antmerlino/SumoBot/Mechanical/Rendering/side.JPG

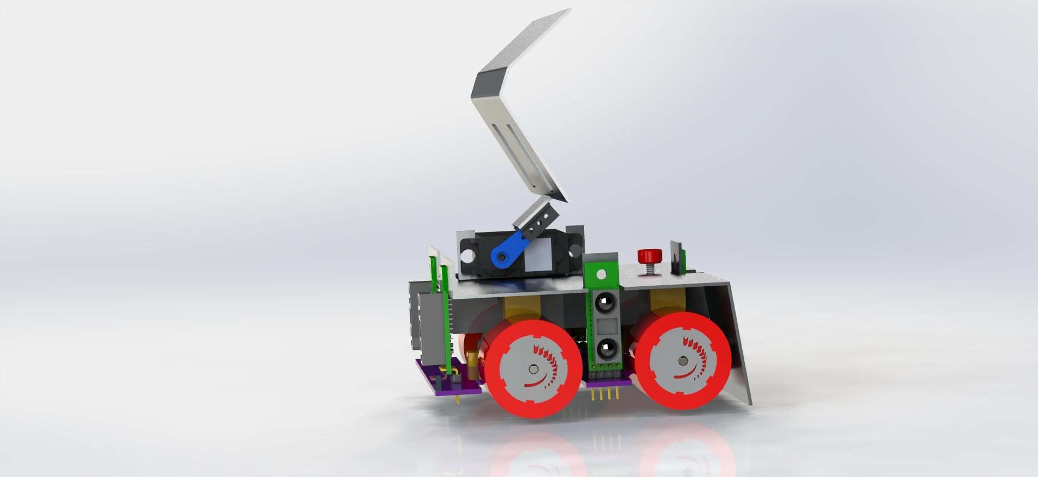
Mechanical/Rendering/side.JPG
