antmerlino/SumoBot/Mechanical/Rendering/back_shot.JPG

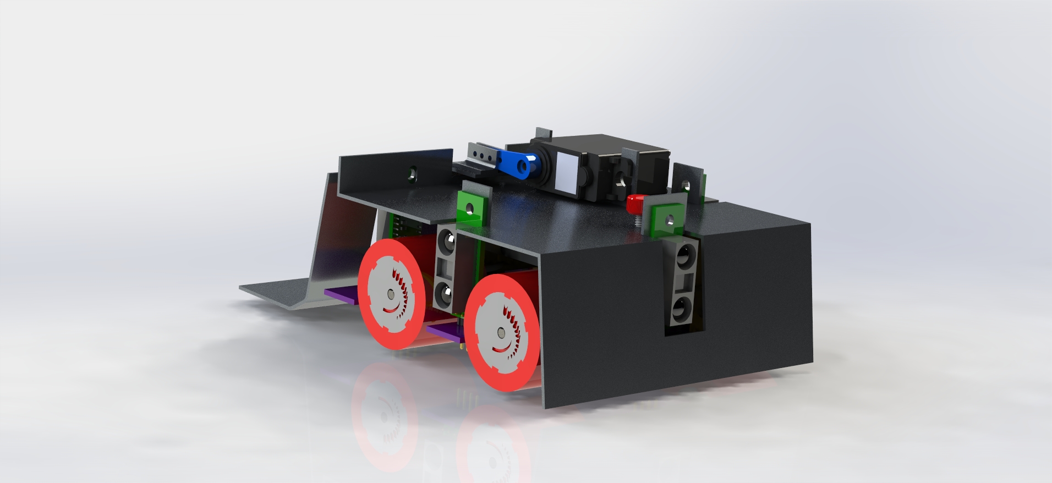
Mechanical/Rendering/back_shot.JPG
