antmerlino/SumoBot/Mechanical/Rendering/akjdlfs.JPG

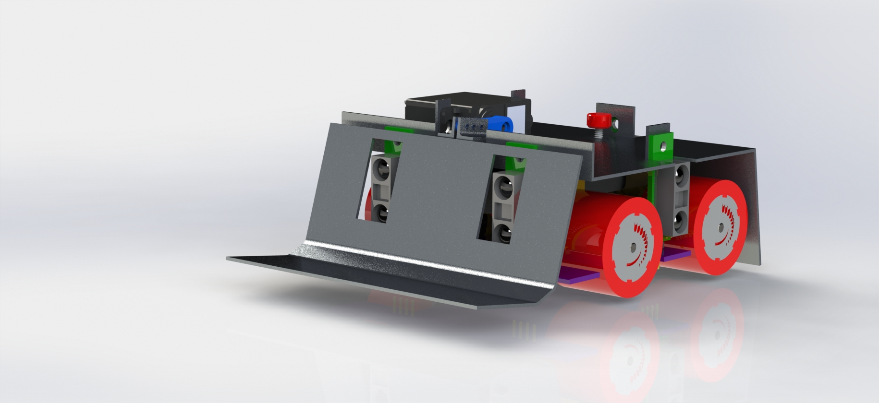
Mechanical/Rendering/akjdlfs.JPG
