antmerlino/SumoBot/Mechanical/Rendering/perspective_preview.JPG

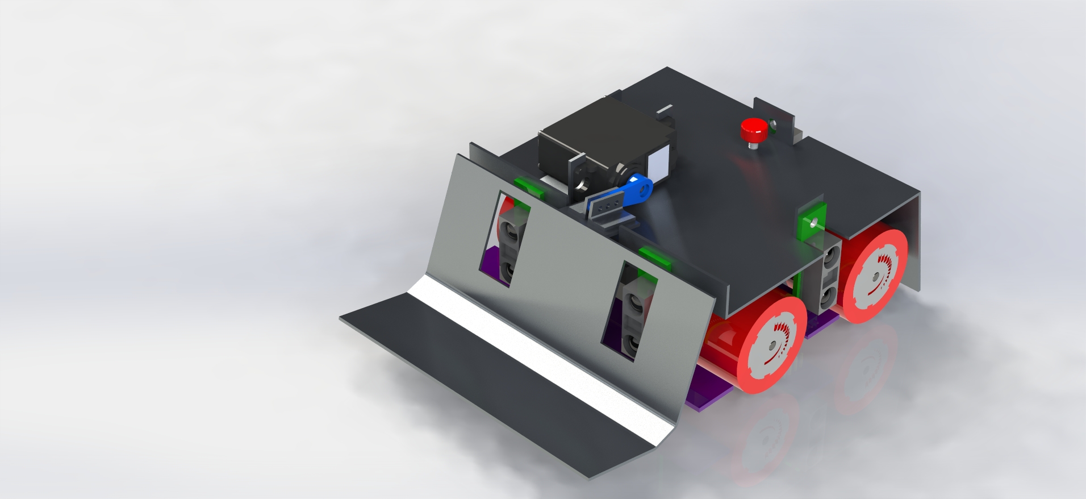
Mechanical/Rendering/perspective_preview.JPG
