antmerlino/SumoBot/Mechanical/Rendering/preview-perspective.JPG

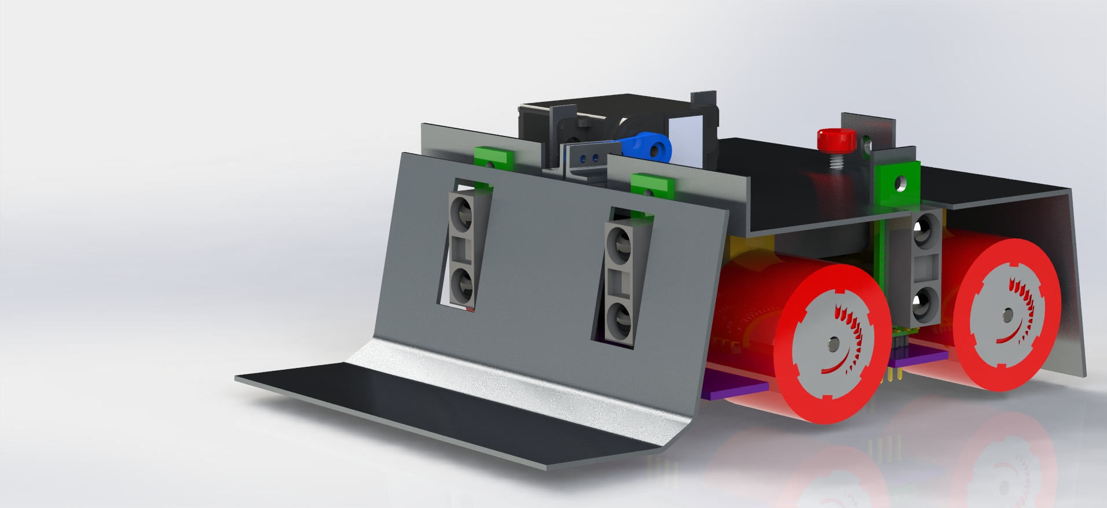
Mechanical/Rendering/preview-perspective.JPG
