antmerlino/SumoBot/Documentation/BOM.ods

Sheet: Sheet1
Micro Metal Gear Motors | 4 | $10.00 | $40.00
FingerTech Wheels | 2 | $16.90 | $33.80
PCB Board | 1 | $23.02 | $23.02
Infrared Proximity | 5 | $11.00 | $55.00
Battery Connector | 1 | $0.70 | $0.70
Batteries | 1 | $6.90 | $6.90
Electronics | 1 | $31.46 | $31.46
Servo and arm | 1 | $40.28 | $40.28
Raw Materials | 1 | $18.00 | $18.00
Total |  |  | $249.16
Micro Metal Gear Motors | 4 | $10.00 | $40.00 | ServoCity | https://www.servocity.com/html/460_rpm_micro_gearmotorblocks.html#.VG-OTPldVCg
FingerTech Wheels | 2 | $16.82 | $33.64 | FingerTech | http://www.fingertechrobotics.com/proddetail.php?prod=ft-minisumo-wheels-1125
PCB Board | 0.333 | 69.05 | $22.99 | OshPark
Infrared Proximity | 5 | $11.95 | $59.75 | Pololu | http://www.pololu.com/product/2474
Batteries | 1 | $6.90 | $6.90 | Ebay
Electronics | 1 | $31.55 | $31.55 | Mouser | See receipt
Servo and arm | 1 | $40.28 | $40.28 | Amazon
Raw Materials | 1 | $12.00 | $12.00 | McMaster | (Over estimated)
Total |  |  | $247.11

Sheet: Sheet2
Motor Controller | 2 | $3.00 | $6.00
Tiva C | 1 | $11.00 | $11.00
Accelerometer | 1 | $3.00 | $3.00
Reflective Sensor | 3 | $1.00 | $3.00
 |  |  | $0.00
 |  |  | $0.00
 |  |  | $0.00
Total |  |  | $23.00

Sheet: Sheet4
Bill of Materials
Micro Metal Gear Motors | 4 | $10.00 | $40.00 | ServoCity | https://www.servocity.com/html/460_rpm_micro_gearmotorblocks.html#.VG-OTPldVCg
FingerTech Wheels | 2 | $16.82 | $33.64 | FingerTech | http://www.fingertechrobotics.com/proddetail.php?prod=ft-minisumo-wheels-1125
PCB Board | 0.333 | 69.05 | $22.99 | OshPark
Infrared Proximity | 5 | $11.95 | $59.75 | Pololu | http://www.pololu.com/product/2474
Batteries | 1 | $6.90 | $6.90 | Ebay
Electronics | 1 | $31.55 | $31.55 | Mouser | See receipt
Servo and arm | 1 | $40.28 | $40.28 | Amazon
Raw Materials | 1 | $12.00 | $12.00 | McMaster | (Over estimated)
Total |  |  | $247.11
