antmerlino/SumoBot/Mechanical/Header Pins/Header_6.SLDASM

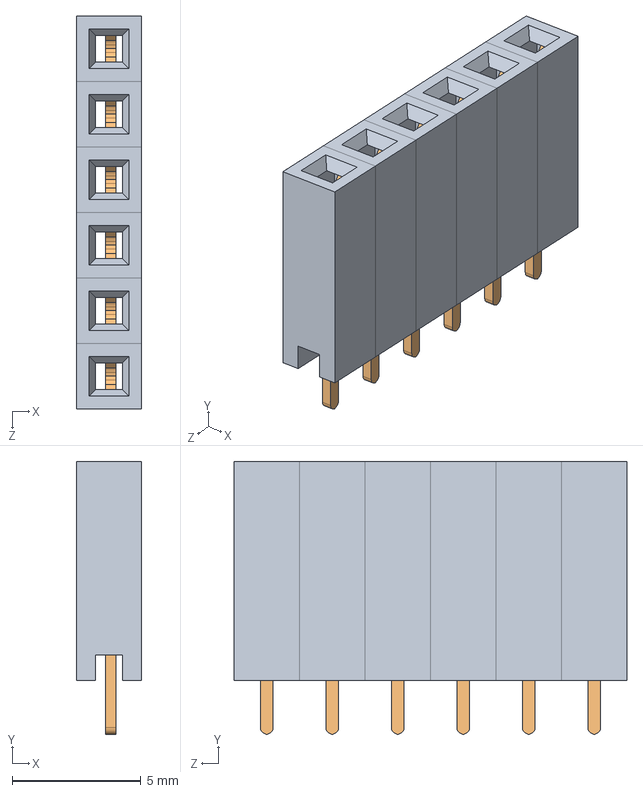
[picture p6: CAD file, 2014-11-15]
Mechanical/Header Pins/Header_6.SLDASM
2.54 x 10.6 x 15.2 mm
header x 6
pin x 6
