antmerlino/SumoBot/Mechanical/wheelAssembly.SLDASM

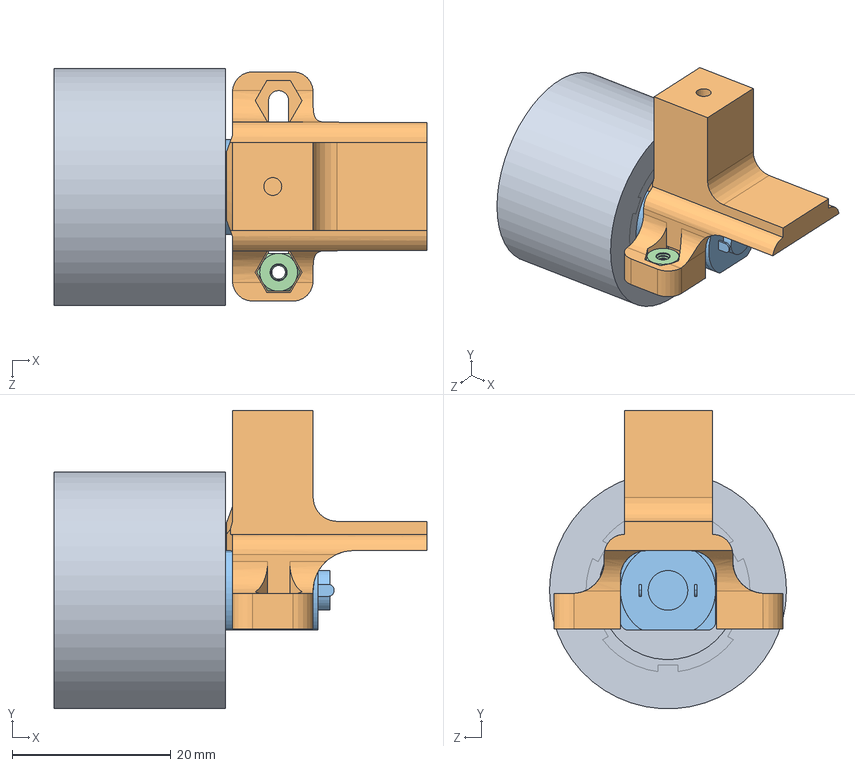
[picture p7: CAD file, 2014-11-23]
Mechanical/wheelAssembly.SLDASM
47.0 x 37.6 x 29.8 mm
cobra_wheels
DualMotorMount
Pololu - 1_250 Micro gear motor
90480A003
