antmerlino/SumoBot/Mechanical/Header Pins/header.SLDASM

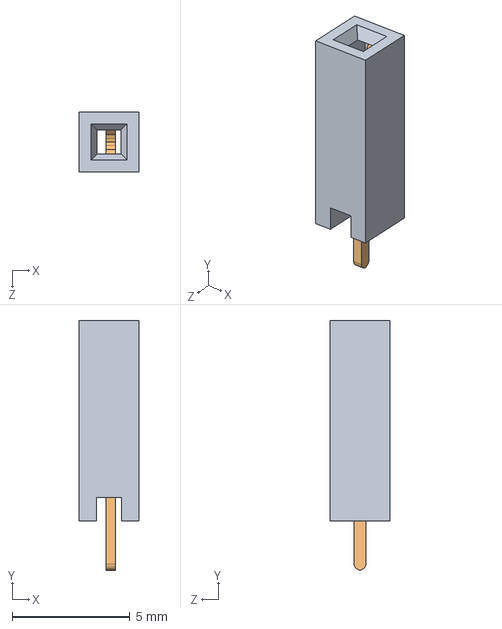
[picture p8: CAD file, 2014-11-15]
Mechanical/Header Pins/header.SLDASM
2.54 x 10.6 x 2.54 mm
header
pin
