antmerlino/SumoBot/Mechanical/HS85MG/HS85MG.SLDASM

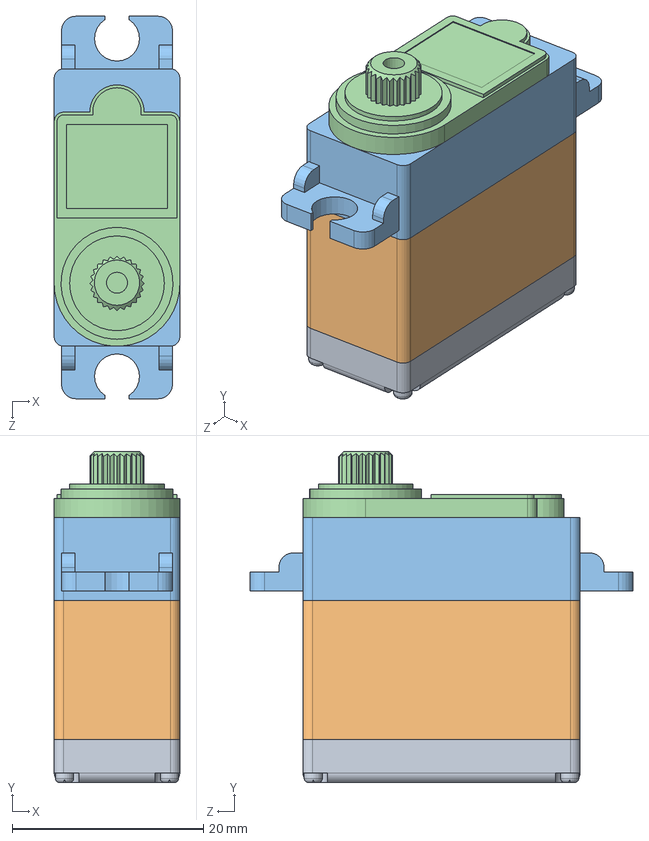
[picture p9: CAD file, 2014-11-15]
Mechanical/HS85MG/HS85MG.SLDASM
13.1 x 34.6 x 40.0 mm
HS85MG_bottom
HS85MG_midle
HS85MG_upper
HS85MG_top
