antmerlino/SumoBot/Mechanical/DualMotorMount.SLDASM

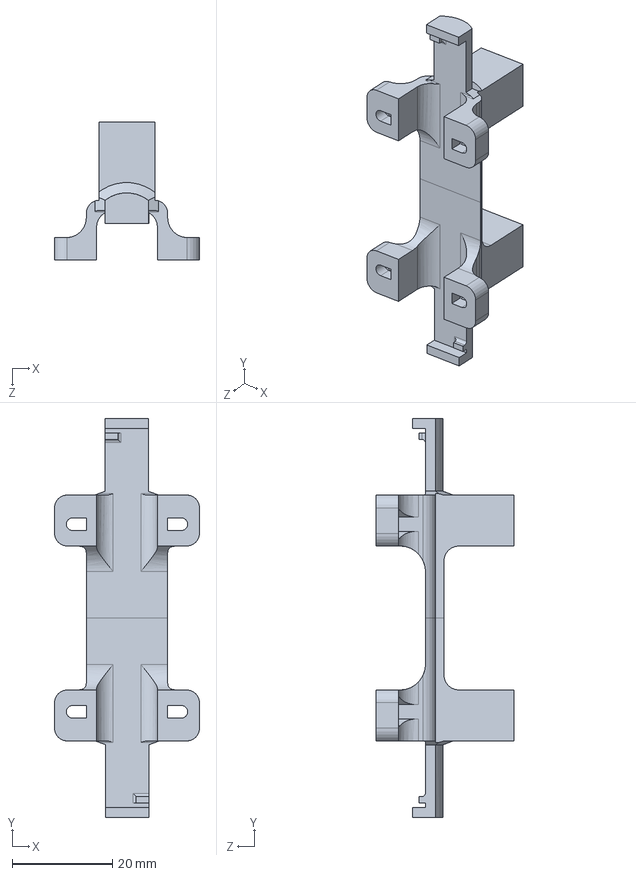
[picture p10: CAD file, 2014-11-23]
Mechanical/DualMotorMount.SLDASM
28.9 x 79.5 x 27.5 mm
DualMotorMount x 2
