antmerlino/SumoBot/Mechanical/Header Pins/Header_4.SLDASM

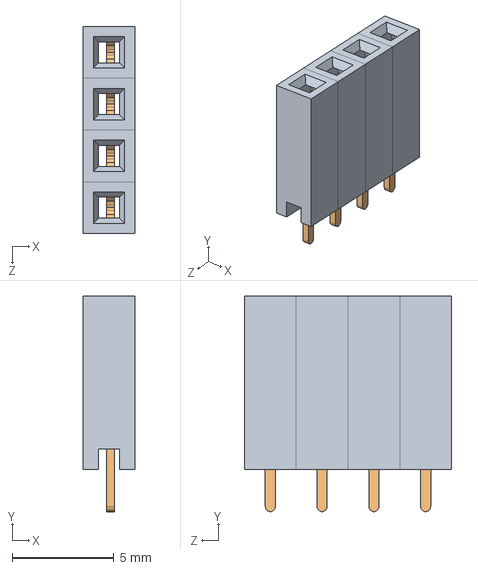
[picture p11: CAD file, 2014-10-20]
Mechanical/Header Pins/Header_4.SLDASM
2.54 x 10.6 x 10.2 mm
header x 4
pin x 4
