antmerlino/SumoBot/Mechanical/sumoBot_3dBody.SLDASM

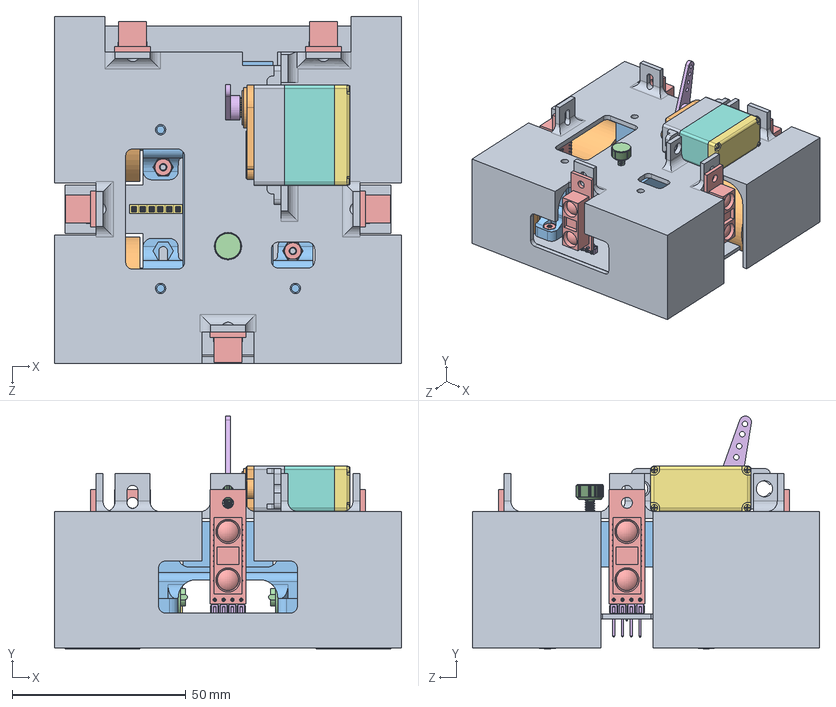
[picture p12: CAD file, 2014-11-23]
Mechanical/sumoBot_3dBody.SLDASM
100.0 x 67.1 x 100.0 mm
BottomBoard
cobra_wheels x 4
DualMotorMount x 4
Pololu - 1_250 Micro gear motor x 4
90480A003 x 4
HI-55701
HS85MG_bottom
HS85MG_midle
HS85MG_upper
HS85MG_top
battery
thumbScrew
sds02a-with-sensor x 5
Pin Header 1x4 TH Angle Pitch 2.54mm x 5
header x 6
pin x 6
3dPrintShielding
