antmerlino/SumoBot/Mechanical/sumoBo5.SLDASM

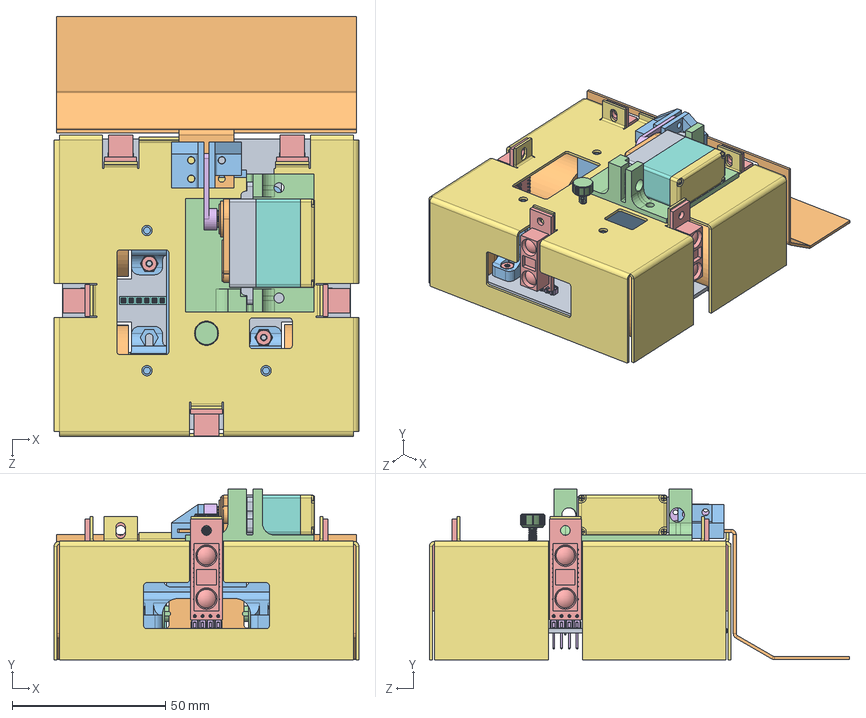
[picture p13: CAD file, 2014-11-23]
Mechanical/sumoBo5.SLDASM
99.5 x 55.7 x 137.2 mm
BottomBoard
cobra_wheels x 4
DualMotorMount x 4
Pololu - 1_250 Micro gear motor x 4
90480A003 x 4
HI-55701
HS85MG_bottom
HS85MG_midle
HS85MG_upper
HS85MG_top
battery
thumbScrew
sds02a-with-sensor x 5
Pin Header 1x4 TH Angle Pitch 2.54mm x 5
SM_BodyShielding
header x 6
pin x 6
SM_Ramp
RampBracket
servoBracket3d
