antmerlino/SumoBot/Mechanical/IR_with_header.SLDASM

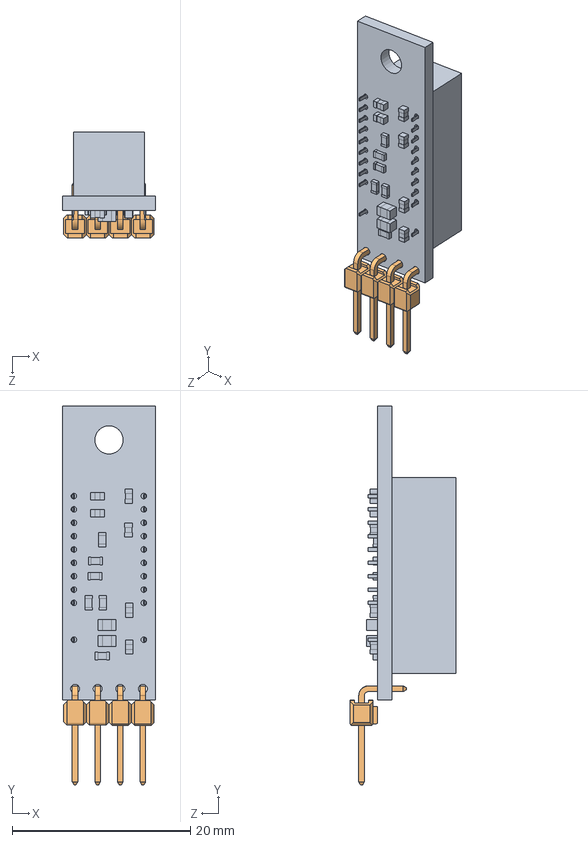
[picture p14: CAD file, 2014-11-15]
Mechanical/IR_with_header.SLDASM
10.4 x 42.5 x 11.8 mm
sds02a-with-sensor
Pin Header 1x4 TH Angle Pitch 2.54mm
