antmerlino/SumoBot/Mechanical/ramp.SLDASM

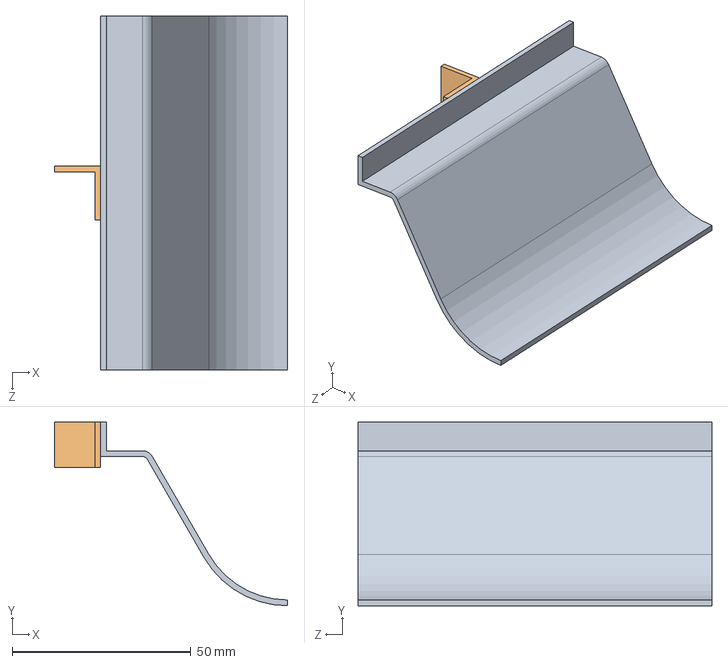
[picture p15: CAD file, 2014-10-20]
Mechanical/ramp.SLDASM
65.2 x 51.3 x 99.1 mm
ramp_plate
ramp_brack
