antmerlino/SumoBot/Hardware/sumobot.step

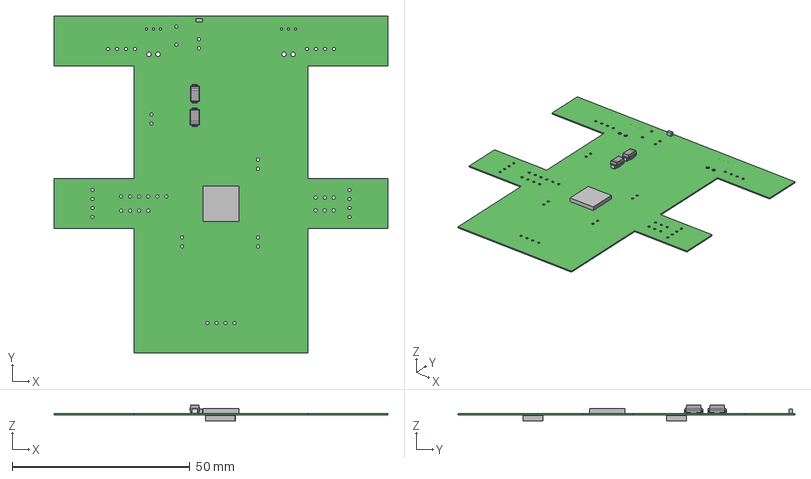
[picture p16: CAD file, 2014-11-15]
Hardware/sumobot.step
94.0 x 94.8 x 4.41 mm
Board
Extruded x 4
SW3dPS-DO-214AC_SMA x 2
User_Library-0603_SMD_Capacitor
