antmerlino/SumoBot/Mechanical/HS85MG/HS85MG_upper.SLDPRT

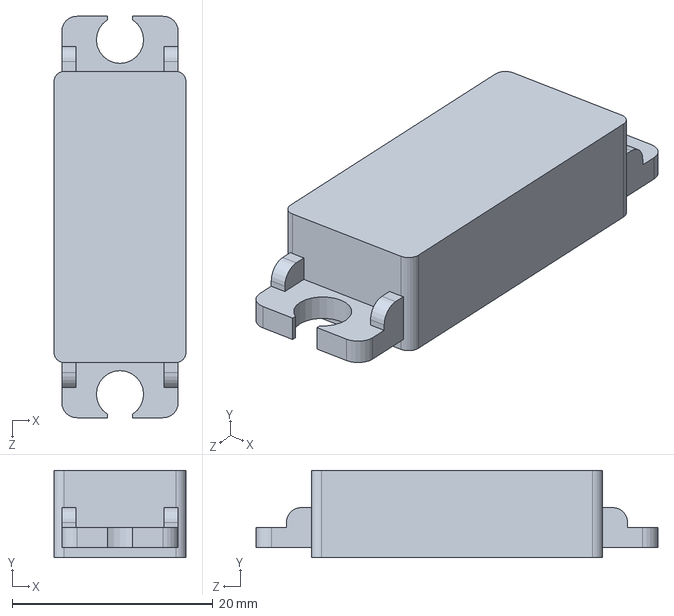
[picture p17: CAD file, 2014-11-15]
Mechanical/HS85MG/HS85MG_upper.SLDPRT
13.1 x 8.70 x 40.0 mm
