antmerlino/SumoBot/Mechanical/RampBracket.SLDPRT

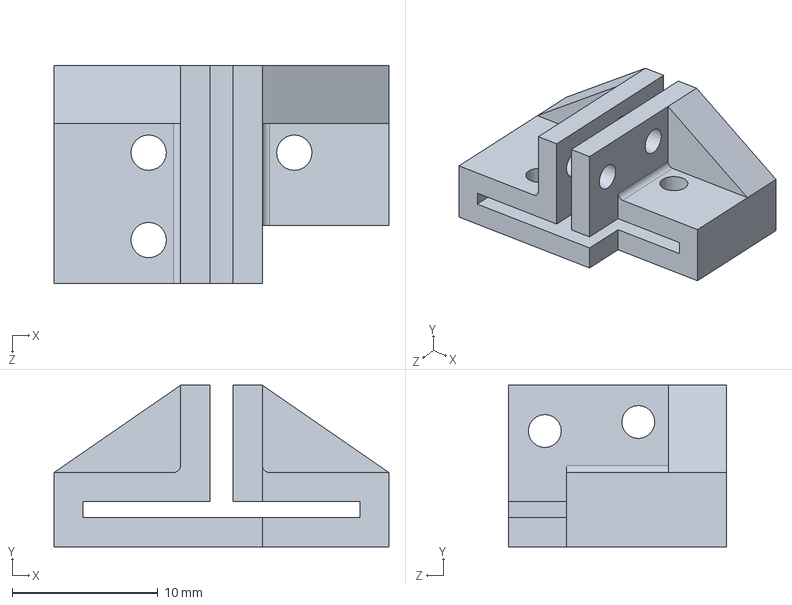
[picture p18: CAD file, 2014-11-23]
Mechanical/RampBracket.SLDPRT
23.0 x 11.1 x 15.0 mm
