antmerlino/SumoBot/Mechanical/HS85MG/HS85MG_top.SLDPRT

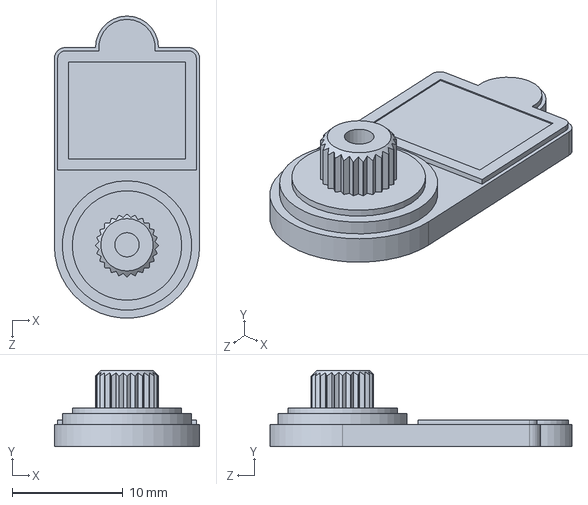
[picture p19: CAD file, 2014-10-20]
Mechanical/HS85MG/HS85MG_top.SLDPRT
13.1 x 6.90 x 27.3 mm
