antmerlino/SumoBot/Mechanical/Header Pins/pin.sldprt

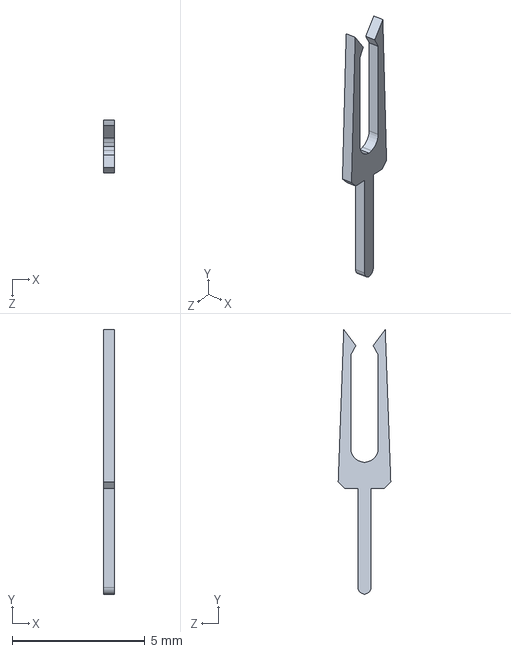
[picture p20: CAD file, 2014-10-20]
Mechanical/Header Pins/pin.sldprt
0.4 x 10.0 x 1.99 mm
