antmerlino/SumoBot/Mechanical/HS85MG/HS85MG - HS85MG_midle-1.STL

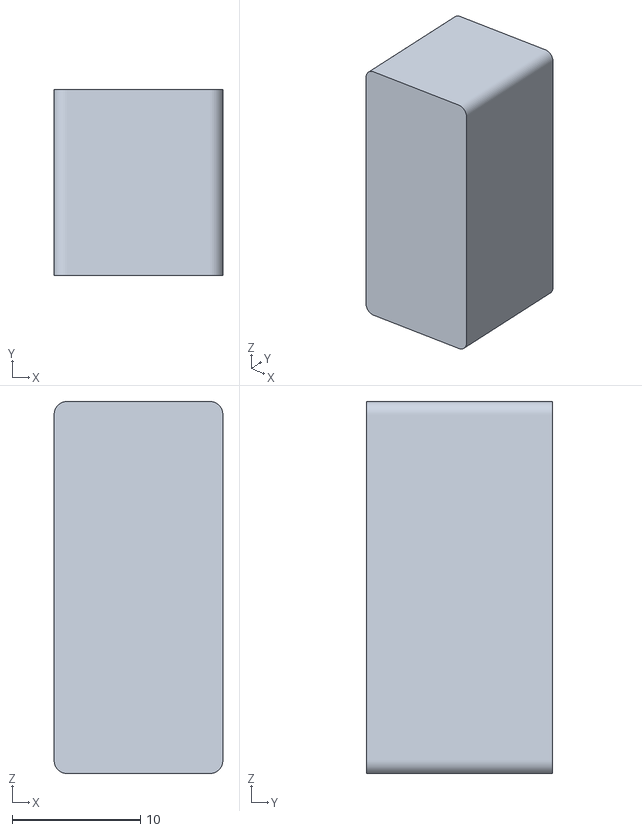
[picture p21: CAD file, 2014-10-20]
Mechanical/HS85MG/HS85MG - HS85MG_midle-1.STL
13.2 x 14.5 x 29.0
