antmerlino/SumoBot/Mechanical/servoBracket3d.SLDPRT

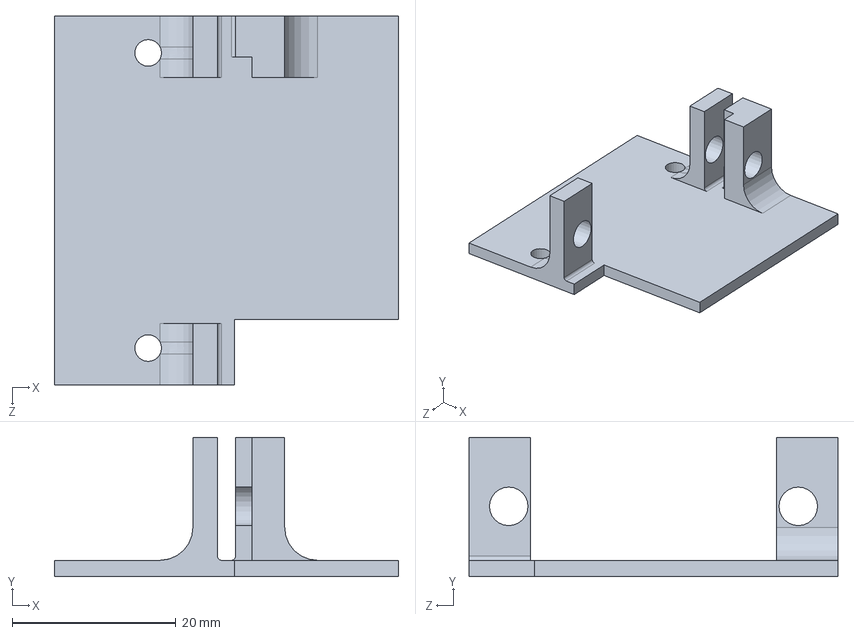
[picture p22: CAD file, 2014-11-23]
Mechanical/servoBracket3d.SLDPRT
42.0 x 17.0 x 45.0 mm
