antmerlino/SumoBot/Mechanical/HS85MG/HS85MG_midle.SLDPRT

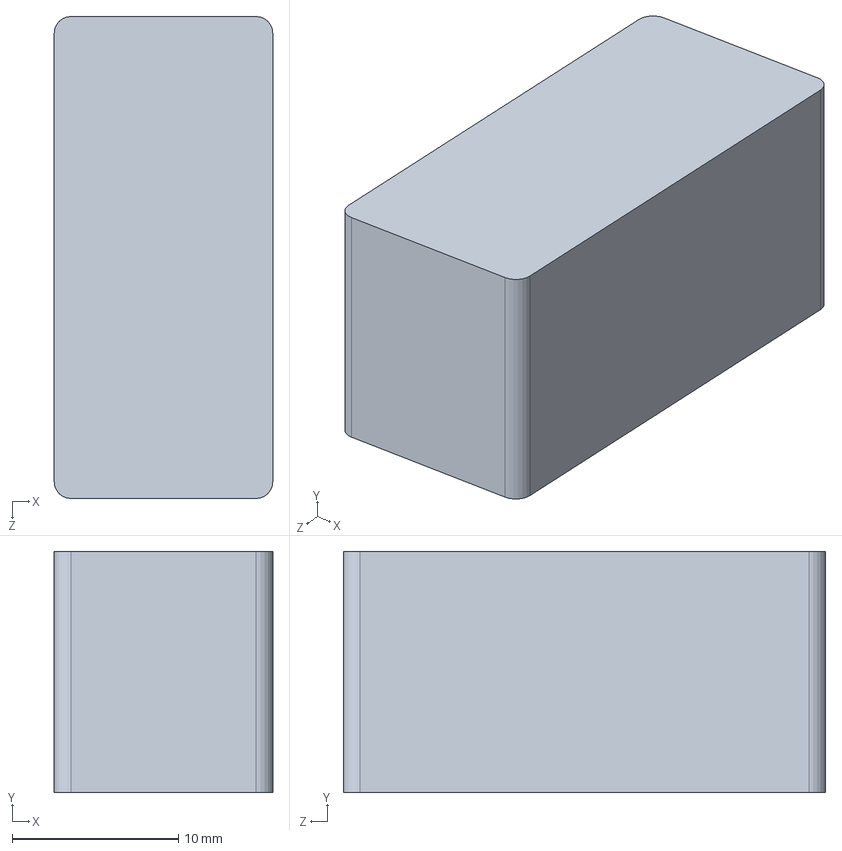
[picture p23: CAD file, 2014-10-20]
Mechanical/HS85MG/HS85MG_midle.SLDPRT
13.1 x 14.5 x 29.0 mm
