antmerlino/SumoBot/Mechanical/3dPrintShielding.SLDPRT

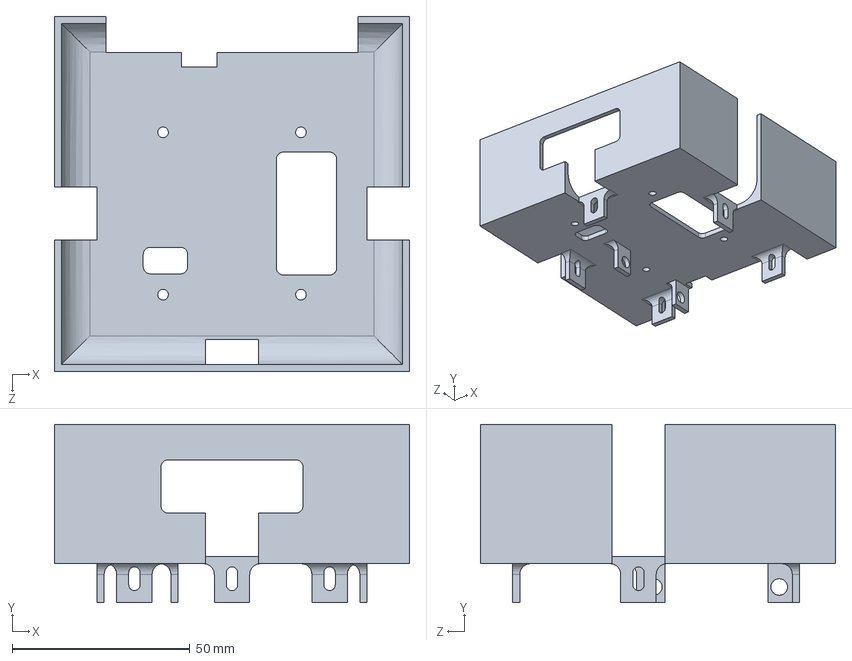
[picture p24: CAD file, 2014-11-23]
Mechanical/3dPrintShielding.SLDPRT
100.0 x 50.2 x 100.0 mm
