antmerlino/SumoBot/Mechanical/Flat pattern - SM_RAMP_BRACKET_RIGHT.DXF

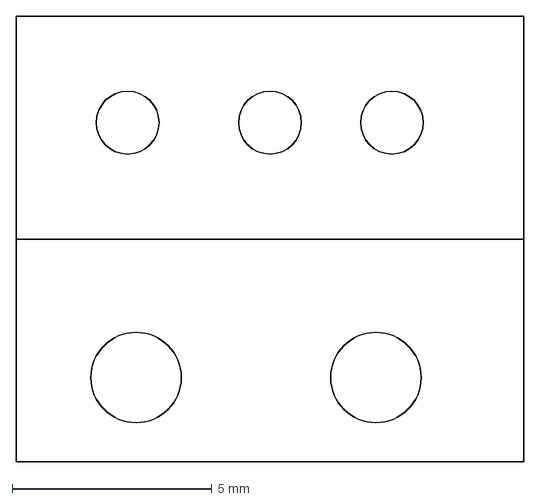
[picture p25: CAD file, 2014-11-15]
Mechanical/Flat pattern - SM_RAMP_BRACKET_RIGHT.DXF
12.7 x 11.1 mm
