antmerlino/SumoBot/Mechanical/HS85MG/HS85MG_bottom.SLDPRT

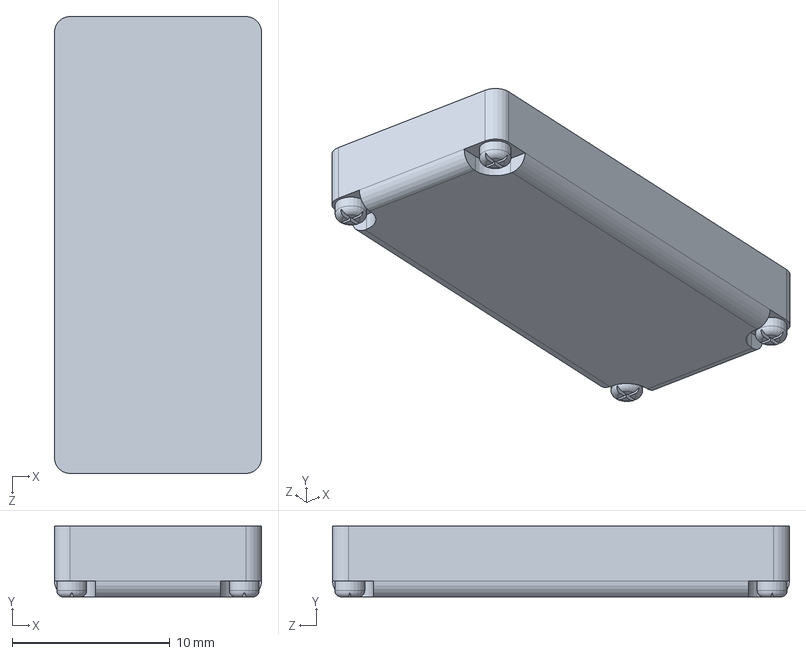
[picture p26: CAD file, 2014-10-20]
Mechanical/HS85MG/HS85MG_bottom.SLDPRT
13.1 x 4.50 x 29.0 mm
