antmerlino/SumoBot/Mechanical/motor_mount_rev2.SLDPRT

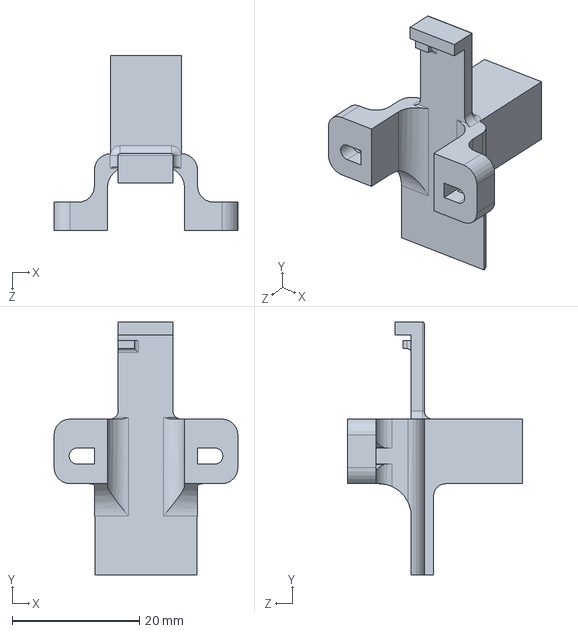
[picture p27: CAD file, 2014-11-15]
Mechanical/motor_mount_rev2.SLDPRT
28.9 x 39.7 x 27.5 mm
