antmerlino/SumoBot/Mechanical/SM_RAMP_BRACKET_RIGHT.SLDPRT

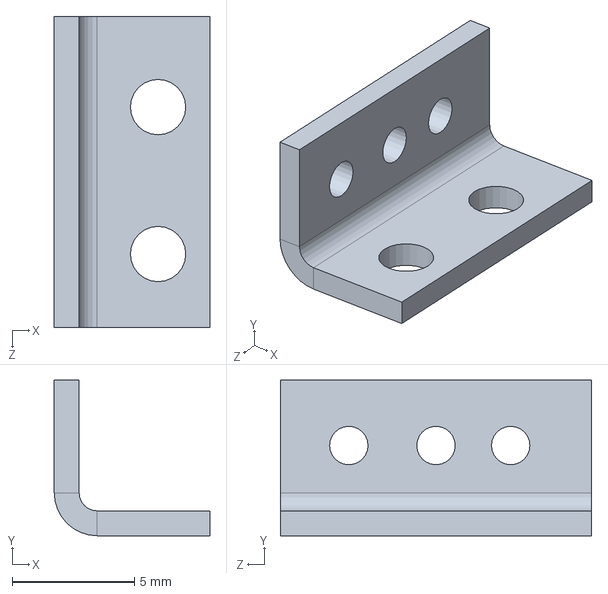
[picture p28: CAD file, 2014-11-15]
Mechanical/SM_RAMP_BRACKET_RIGHT.SLDPRT
6.35 x 6.35 x 12.7 mm
