antmerlino/SumoBot/Mechanical/Flat pattern - SM_RAMP_BRACKET_LEFT.DXF

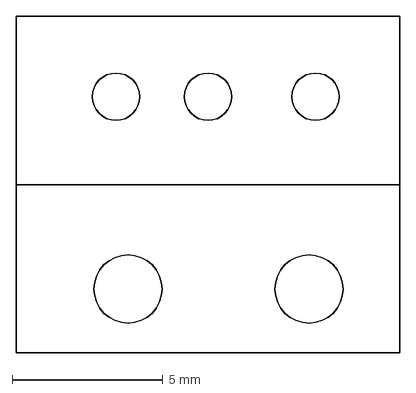
[picture p29: CAD file, 2014-11-15]
Mechanical/Flat pattern - SM_RAMP_BRACKET_LEFT.DXF
12.7 x 11.1 mm
