antmerlino/SumoBot/Mechanical/Flat pattern - SM_Ramp.DXF

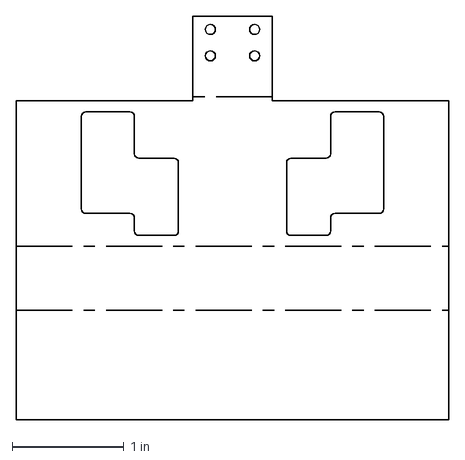
[picture p30: CAD file, 2014-11-15]
Mechanical/Flat pattern - SM_Ramp.DXF
3.86 x 3.60 in
