antmerlino/SumoBot/Mechanical/Board.sldprt

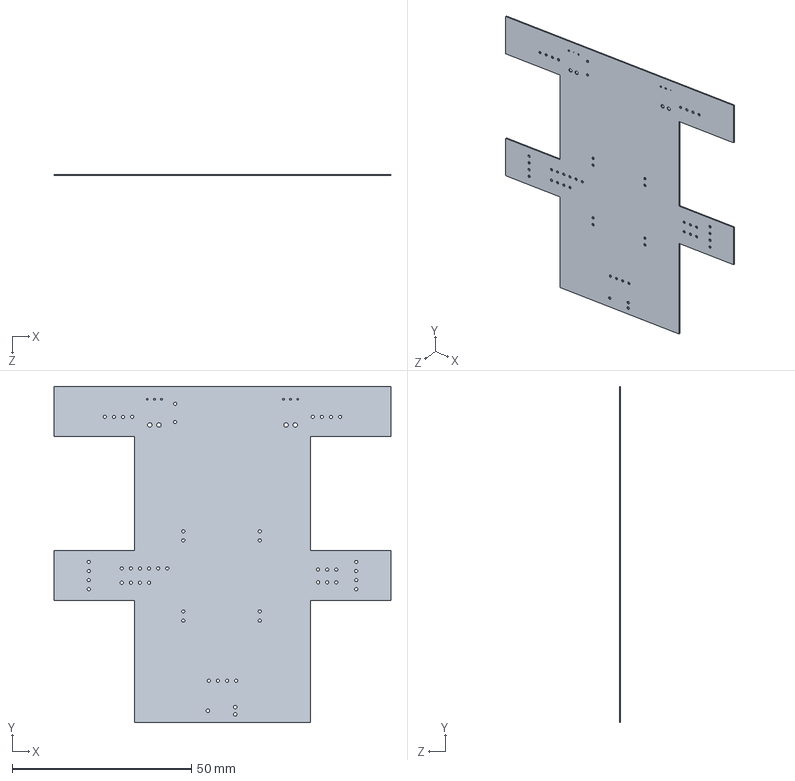
[picture p31: CAD file, 2014-11-15]
Mechanical/Board.sldprt
94.0 x 93.8 x 0.411 mm
