antmerlino/SumoBot/Mechanical/servo_bracket.SLDPRT

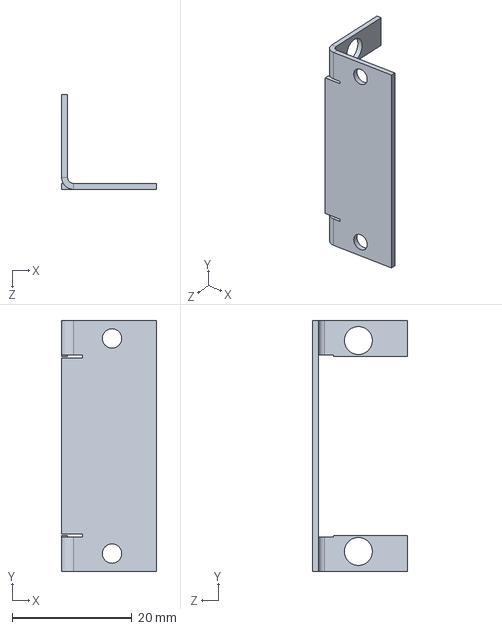
[picture p32: CAD file, 2014-11-15]
Mechanical/servo_bracket.SLDPRT
15.9 x 42.0 x 15.9 mm
