antmerlino/SumoBot/Mechanical/BottomBoard.SLDPRT

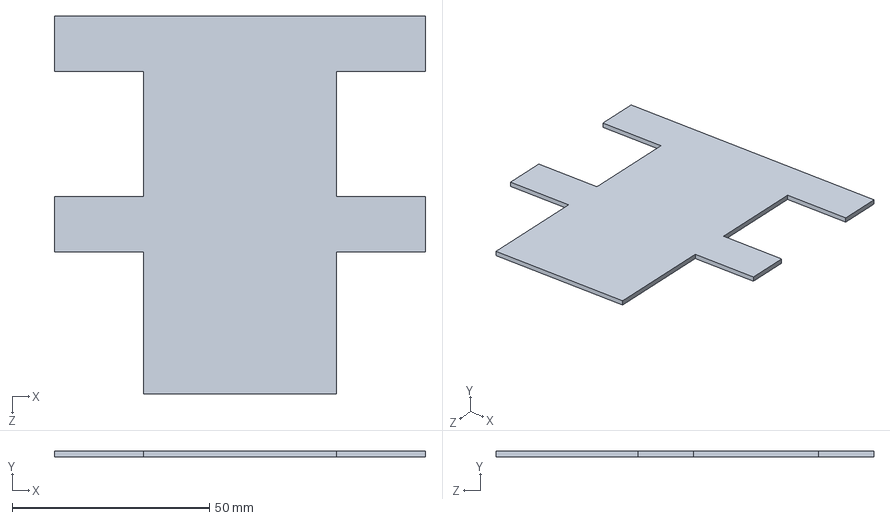
[picture p33: CAD file, 2014-11-15]
Mechanical/BottomBoard.SLDPRT
94.0 x 1.50 x 95.8 mm
