antmerlino/SumoBot/Mechanical/Flat pattern - SM_BodyShielding.DXF

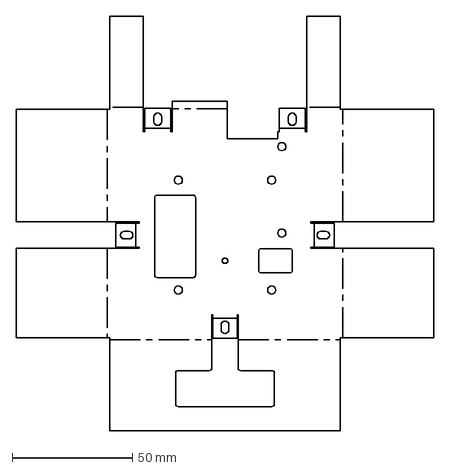
[picture p34: CAD file, 2014-11-15]
Mechanical/Flat pattern - SM_BodyShielding.DXF
173.8 x 172.8 mm
