antmerlino/SumoBot/Mechanical/SM_BodyShielding.SLDPRT

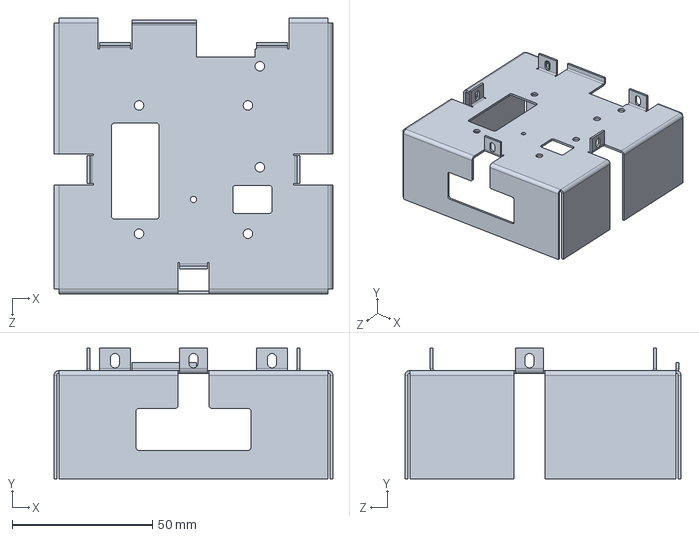
[picture p35: CAD file, 2014-11-15]
Mechanical/SM_BodyShielding.SLDPRT
99.5 x 46.7 x 98.5 mm
