antmerlino/SumoBot/Mechanical/SM_Ramp.SLDPRT

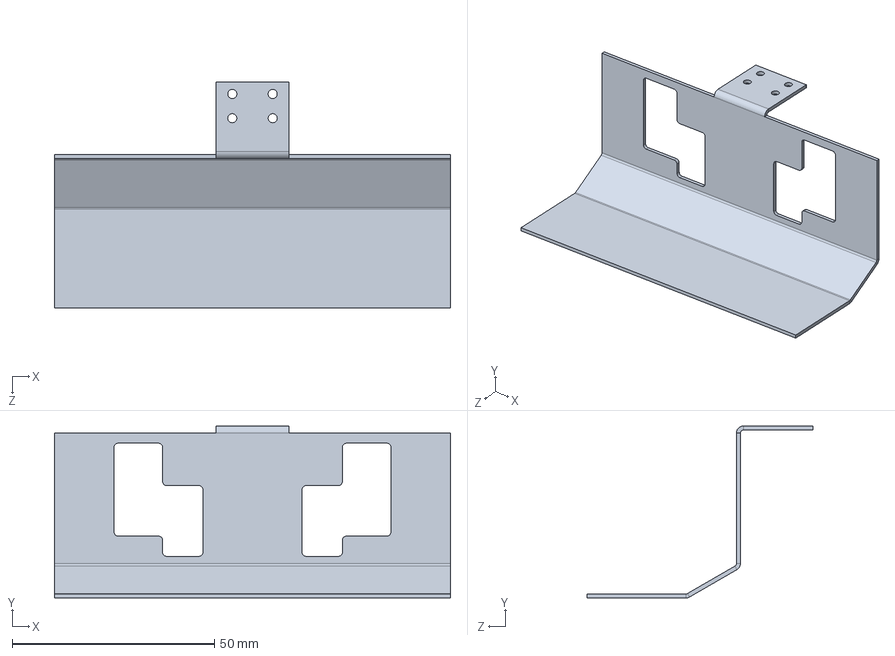
[picture p36: CAD file, 2014-11-15]
Mechanical/SM_Ramp.SLDPRT
98.0 x 42.6 x 56.0 mm
