antmerlino/SumoBot/Mechanical/motor_mount_TOP.DXF

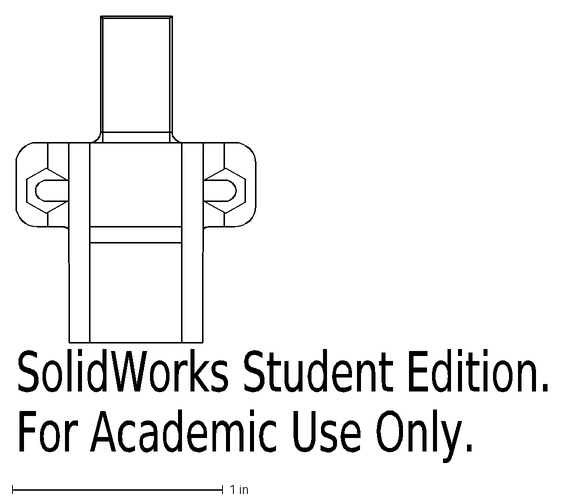
[picture p37: CAD file, 2014-11-15]
Mechanical/motor_mount_TOP.DXF
SolidWorks Student Edition.
For Academic Use Only.
