antmerlino/SumoBot/Mechanical/Flat pattern - servo_bracket.DXF

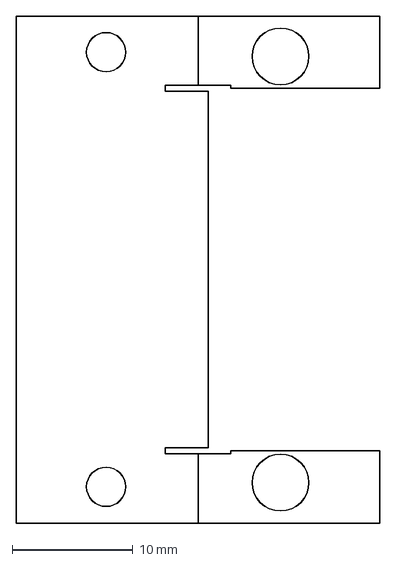
[picture p38: CAD file, 2014-11-15]
Mechanical/Flat pattern - servo_bracket.DXF
30.1 x 42.0 mm
