antmerlino/SumoBot/Mechanical/ramp_brack_opposite.SLDPRT

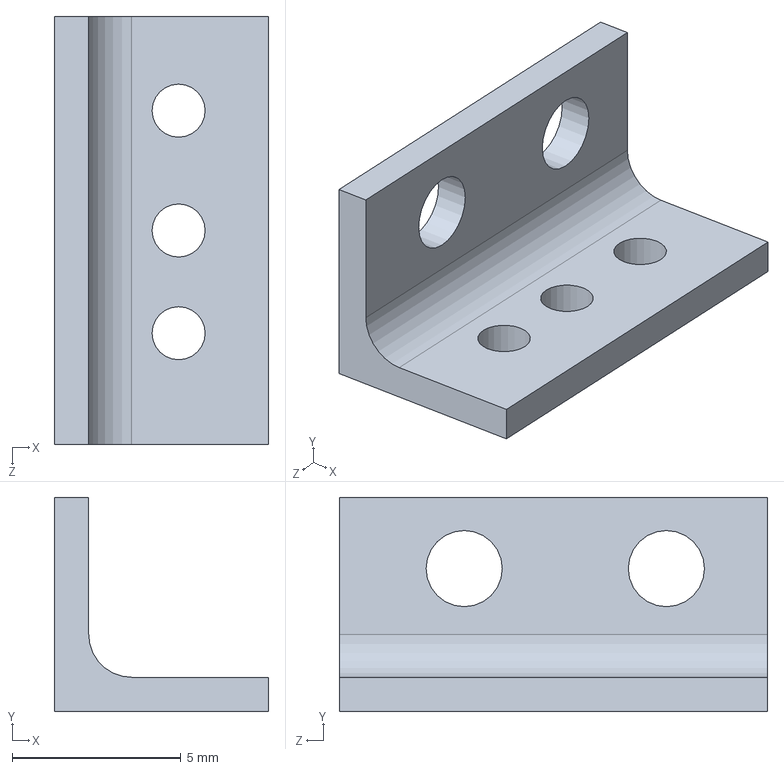
[picture p39: CAD file, 2014-11-15]
Mechanical/ramp_brack_opposite.SLDPRT
6.35 x 6.35 x 12.7 mm
