antmerlino/SumoBot/Mechanical/Pololu - 1_250 Micro gear motor.SLDPRT

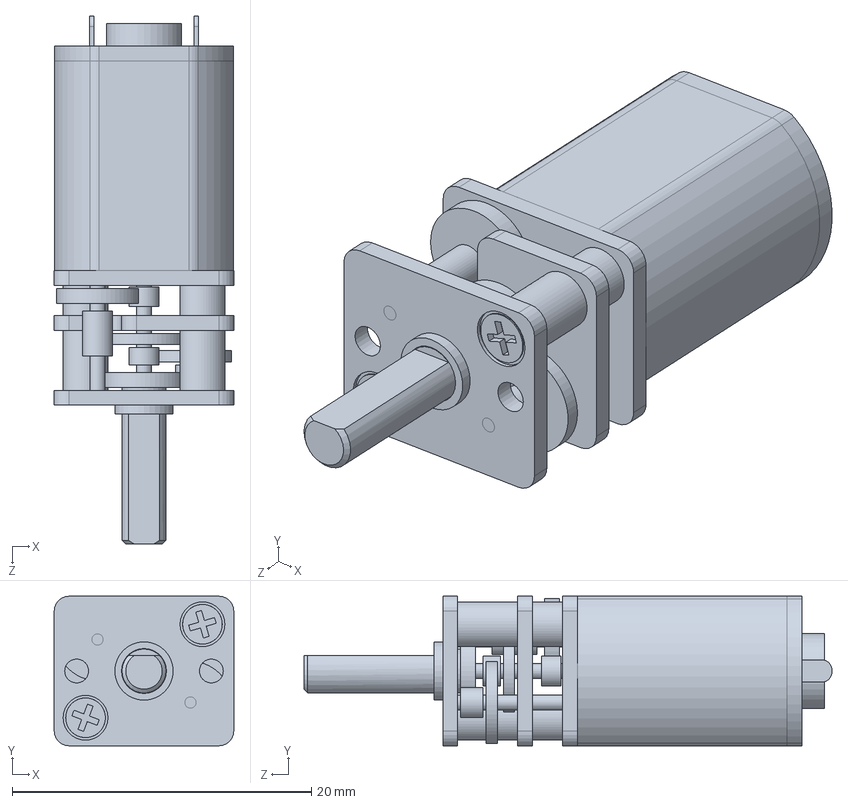
[picture p40: CAD file, 2014-10-20]
Mechanical/Pololu - 1_250 Micro gear motor.SLDPRT
12.0 x 10.0 x 35.3 mm
