antmerlino/SumoBot/Mechanical/ir_bracket.SLDPRT

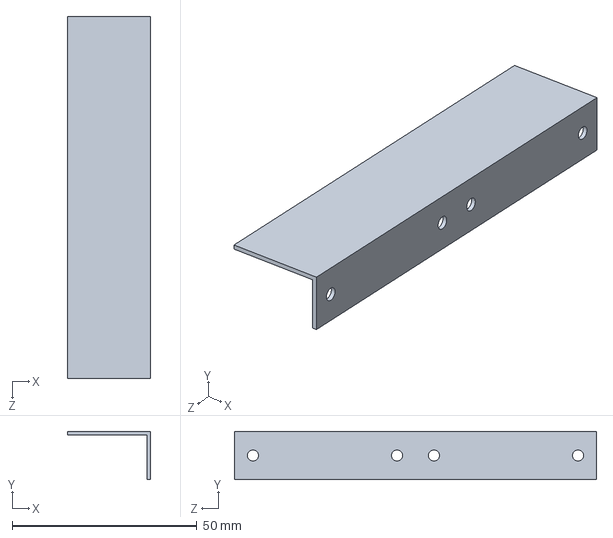
[picture p41: CAD file, 2014-10-20]
Mechanical/ir_bracket.SLDPRT
22.5 x 13.0 x 98.0 mm
