antmerlino/SumoBot/Mechanical/IR Sensor.SLDPRT

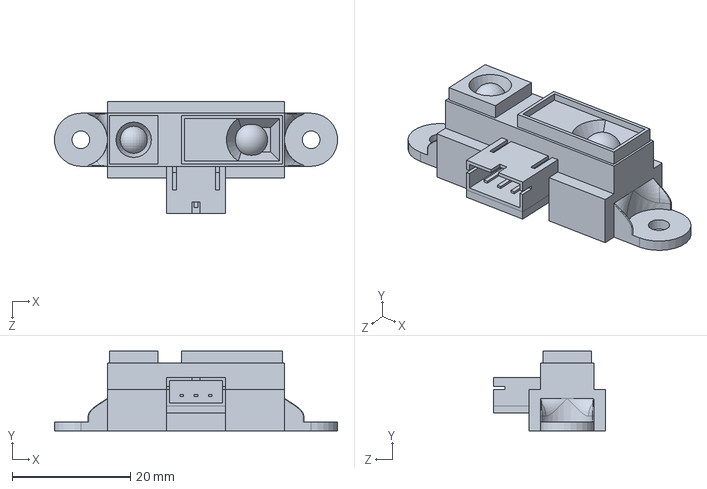
[picture p42: CAD file, 2014-10-20]
Mechanical/IR Sensor.SLDPRT
47.9 x 13.5 x 19.0 mm
