antmerlino/SumoBot/Mechanical/Servo Arm HXT900 Micro.sldprt

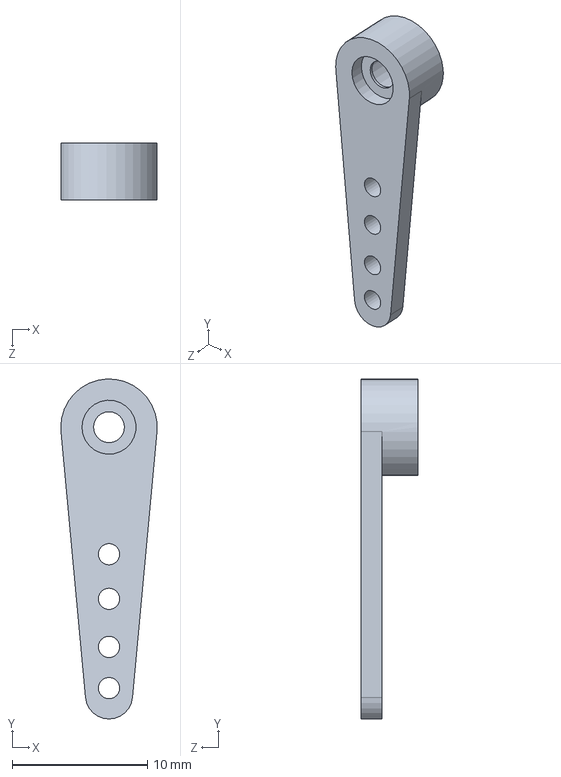
[picture p43: CAD file, 2014-10-20]
Mechanical/Servo Arm HXT900 Micro.sldprt
7.14 x 25.2 x 4.19 mm
