antmerlino/SumoBot/Mechanical/Servo HXT900 Micro.SLDPRT

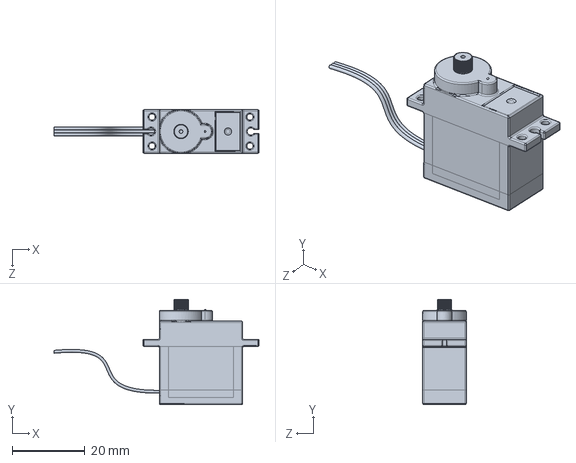
[picture p44: CAD file, 2014-10-20]
Mechanical/Servo HXT900 Micro.SLDPRT
56.5 x 29.0 x 12.0 mm
