antmerlino/SumoBot/Mechanical/battery.SLDPRT

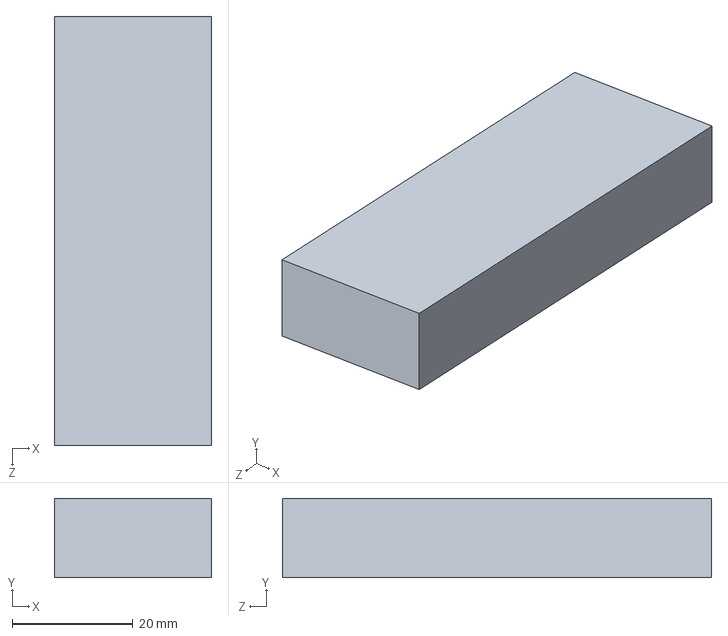
[picture p45: CAD file, 2014-10-20]
Mechanical/battery.SLDPRT
26.0 x 13.1 x 71.0 mm
