antmerlino/SumoBot/Mechanical/TopBoard.SLDPRT

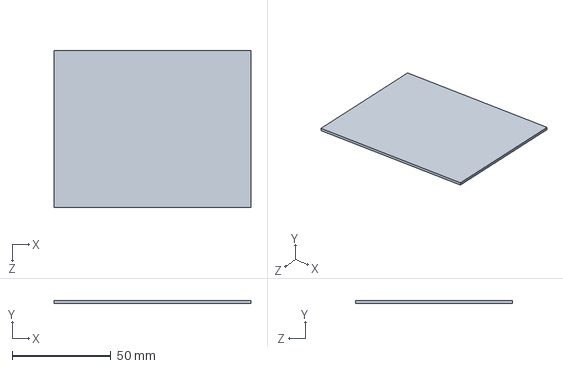
[picture p46: CAD file, 2014-10-20]
Mechanical/TopBoard.SLDPRT
100.0 x 1.50 x 79.5 mm
