antmerlino/SumoBot/Mechanical/Bluetooth Modem - BlueSMiRF Gold - WRL-102681.SLDPRT

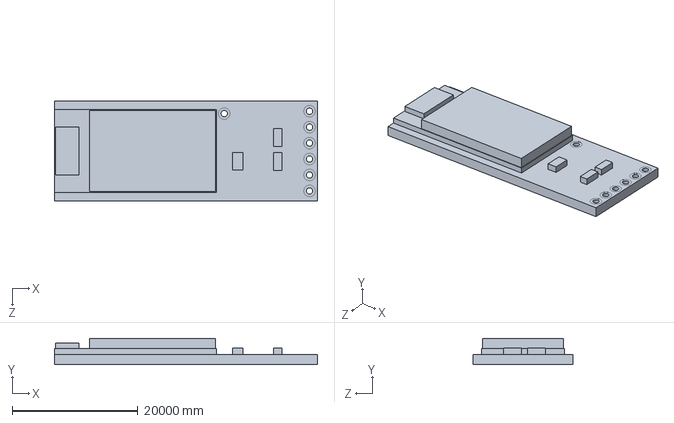
[picture p47: CAD file, 2014-10-20]
Mechanical/Bluetooth Modem - BlueSMiRF Gold - WRL-102681.SLDPRT
41888.9 x 4203.7 x 15980.8 mm
