antmerlino/SumoBot/Mechanical/cobra_wheels.SLDPRT

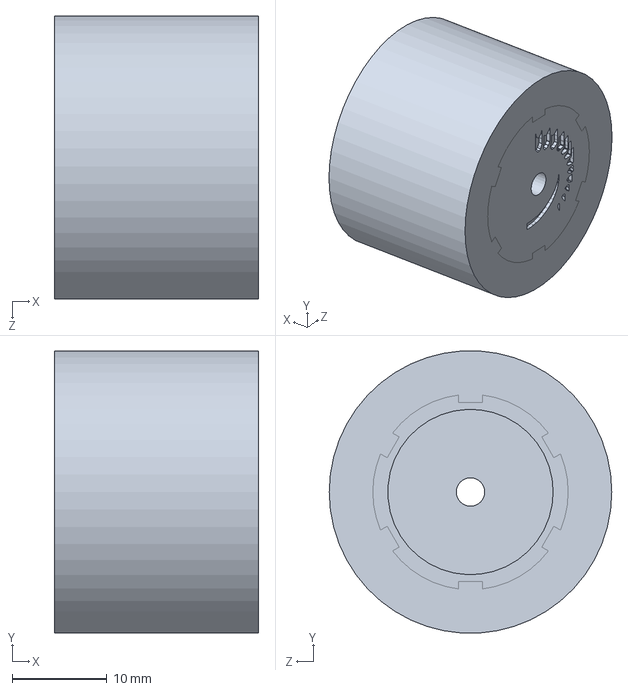
[picture p48: CAD file, 2014-10-20]
Mechanical/cobra_wheels.SLDPRT
21.6 x 29.8 x 29.8 mm
