antmerlino/SumoBot/Mechanical/sds02a-with-sensor.SLDPRT

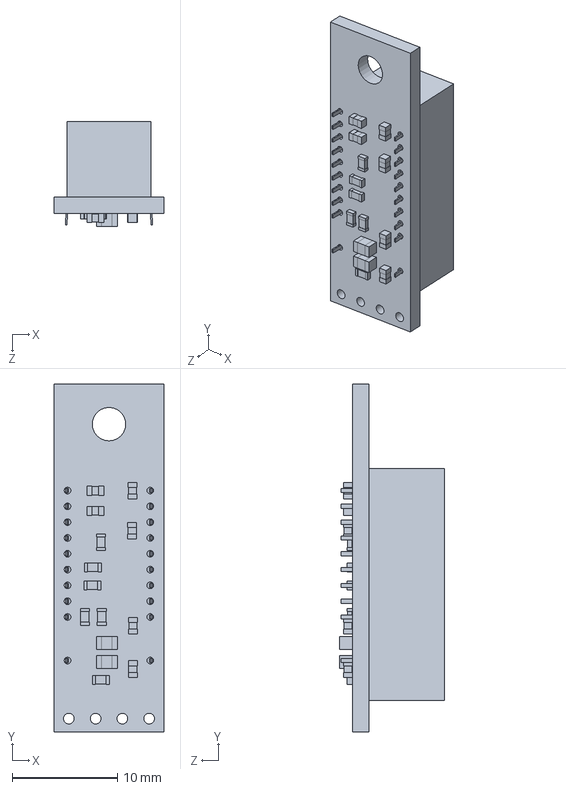
[picture p49: CAD file, 2014-10-20]
Mechanical/sds02a-with-sensor.SLDPRT
10.4 x 33.0 x 10.0 mm
