antmerlino/SumoBot/Mechanical/back_plate.SLDPRT

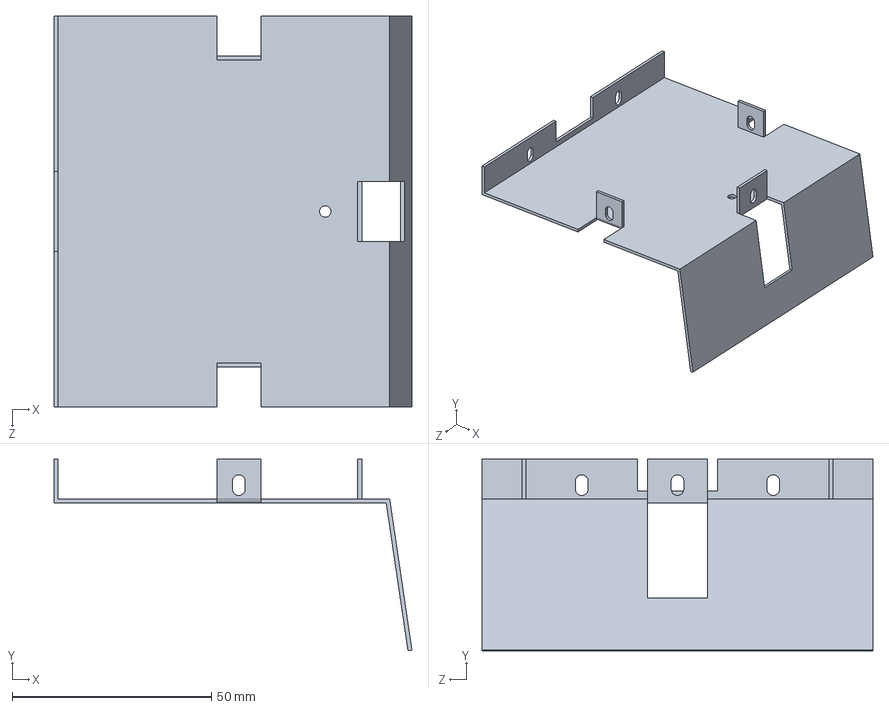
[picture p50: CAD file, 2014-10-20]
Mechanical/back_plate.SLDPRT
89.7 x 48.0 x 98.0 mm
