antmerlino/SumoBot/Mechanical/Pin Header 1x4 TH Angle Pitch 2.54mm.stp

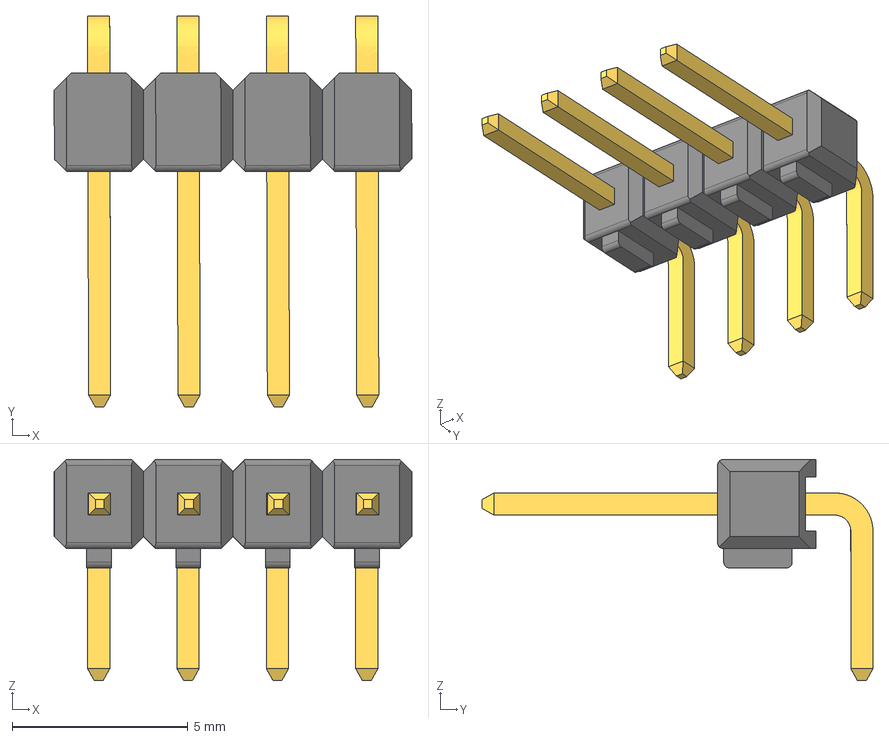
[picture p51: CAD file, 2014-10-20]
Mechanical/Pin Header 1x4 TH Angle Pitch 2.54mm.stp
10.2 x 11.1 x 6.29 mm
