antmerlino/SumoBot/(list of files, cad)

Other CAD files:
Hardware/U4.sldasm
Hardware/3D/D4.sldasm
Hardware/3D/U5.sldasm
Hardware/3D/D3.sldasm
Hardware/3D/D2.sldasm
Hardware/3D/U1.sldasm
Hardware/3D/Extruded_4.sldprt
Hardware/3D/Board.sldprt
Hardware/3D/Extruded_2.sldprt
Mechanical/HS85MG/HS85MG - HS85MG_top-1.STL
Hardware/3D/Extruded_3.sldprt
Hardware/3D/SW3dPS-DO-214AC_SMA.sldprt
Mechanical/HS85MG/HS85MG - HS85MG_upper-1.STL
Mechanical/HS85MG/HS85MG - HS85MG_bottom-1.STL
Hardware/3D/Extruded.sldprt
Hardware/3D/User_Library-0603_SMD_Capacitor.sldprt
Mechanical/SM_RAMP_BRACKET_LEFT.SLDPRT
Mechanical/ramp_brack.SLDPRT
Mechanical/M2.5_ThinNut.SLDPRT
Hardware/3D/575414720.sldasm
Hardware/3D/642238864.sldasm
Hardware/3D/642239760.sldasm
Hardware/3D/sumobot.SLDASM
Hardware/703633856.sldasm
Mechanical/3dPrintShielding.STL
Mechanical/90480A003.SLDPRT
Mechanical/BottomBoard.DXF
Mechanical/DualMotorMount.SLDPRT
Mechanical/DualMotorMount.STL
Mechanical/HS85MG/HS85MG.IGS
Mechanical/Header Pins/header.SLDPRT
Mechanical/M2.5_MachineScrew_4MM.SLDPRT
Mechanical/Pin Header 1x4 TH Angle Pitch 2.54mm.SLDPRT
Mechanical/Pin Header 1x4 TH Angle Pitch 2.54mm.igs
Mechanical/RampBracket.STL
Mechanical/servoBracket3d.STL
Mechanical/thumbScrew.SLDPRT
