antmerlino/SumoBot/Hardware/SumoBot_Hardware_Rev01.PDF

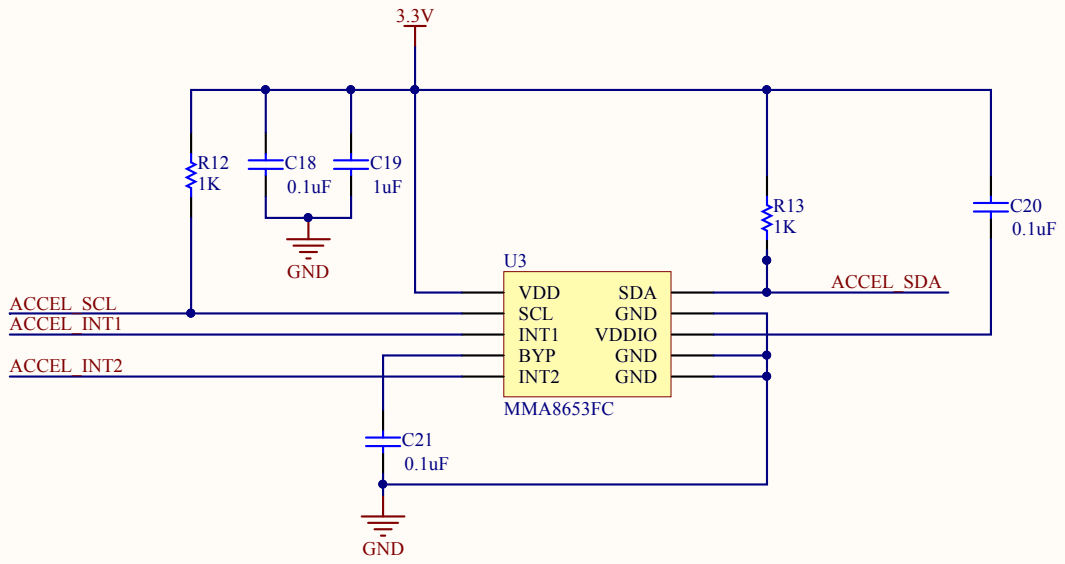
[picture p52: page 1]

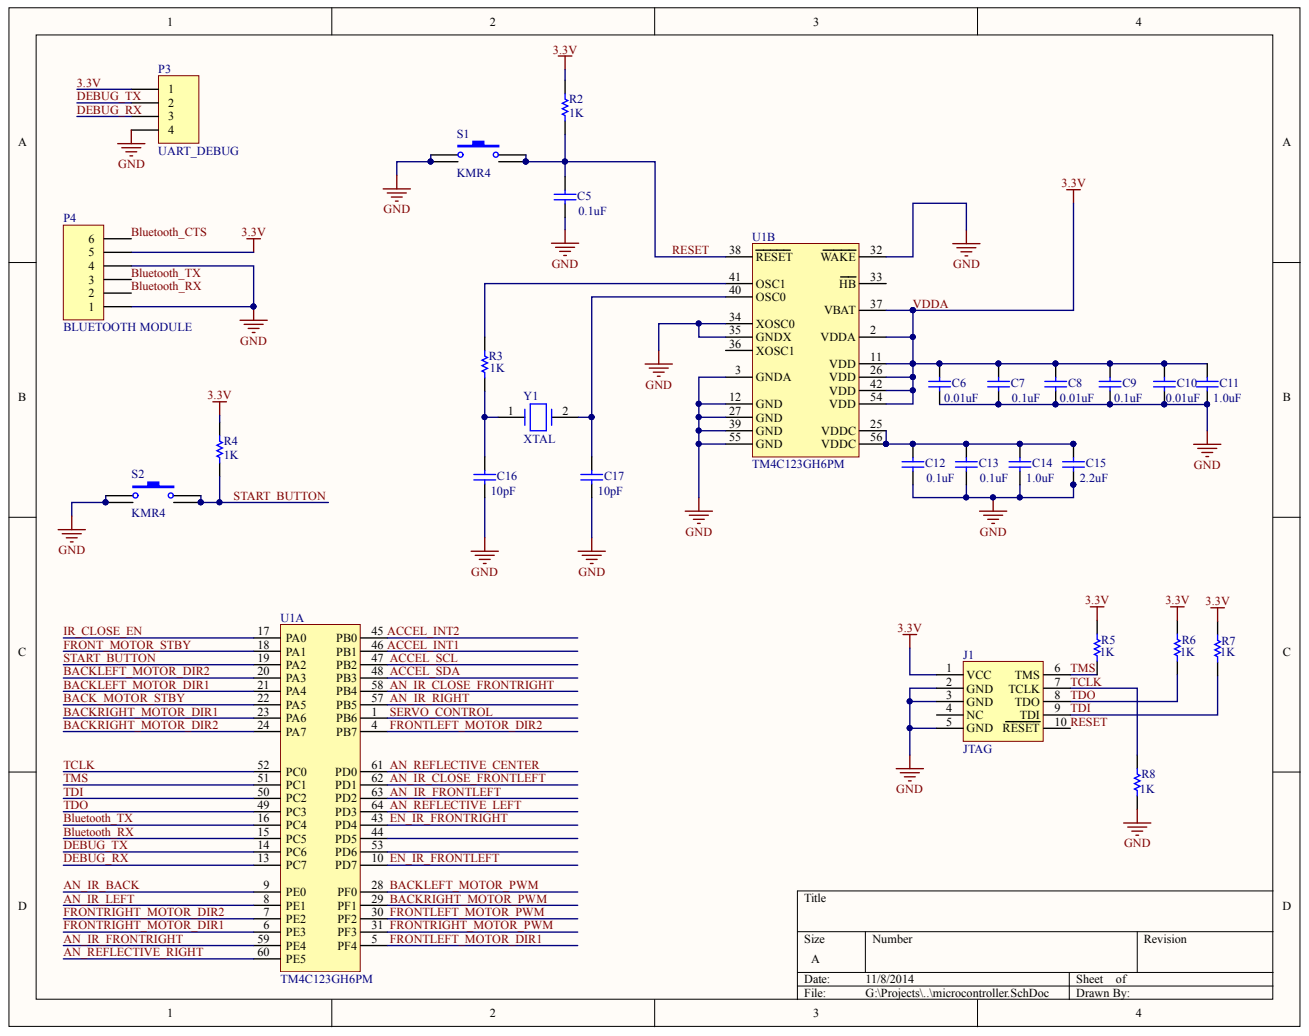
[picture p53: page 2]

XOSC0 34
GNDX 35
XOSC1 36

GNDA 3

GND 12

GND 39

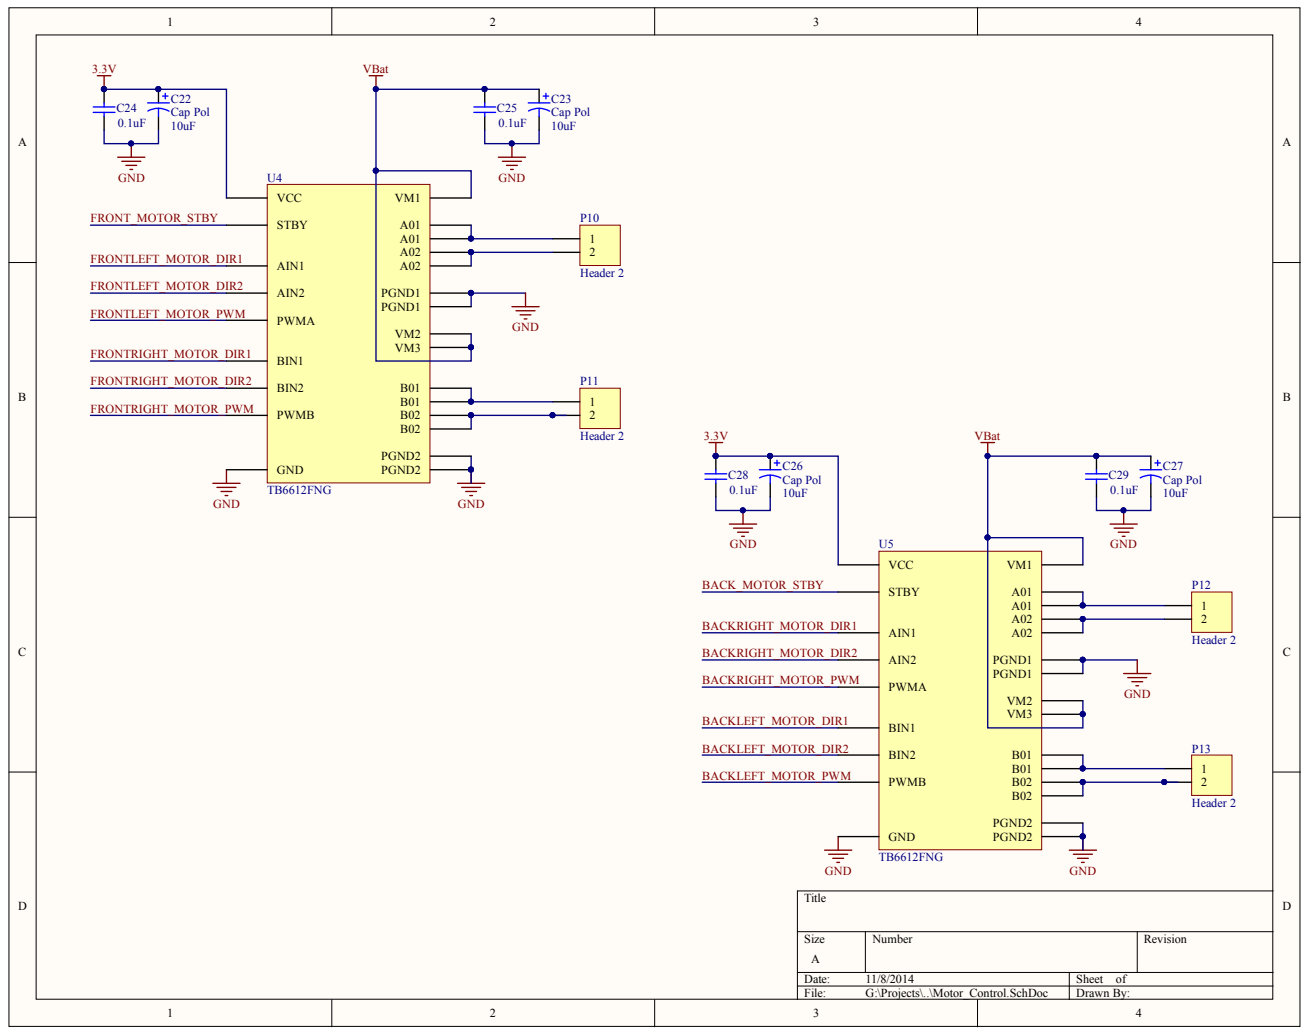
[picture p54: page 3]

BIN2 PWMB GND | VM1

A01 A01 A02 A02 PGND1 PGND1 VM2 VM3

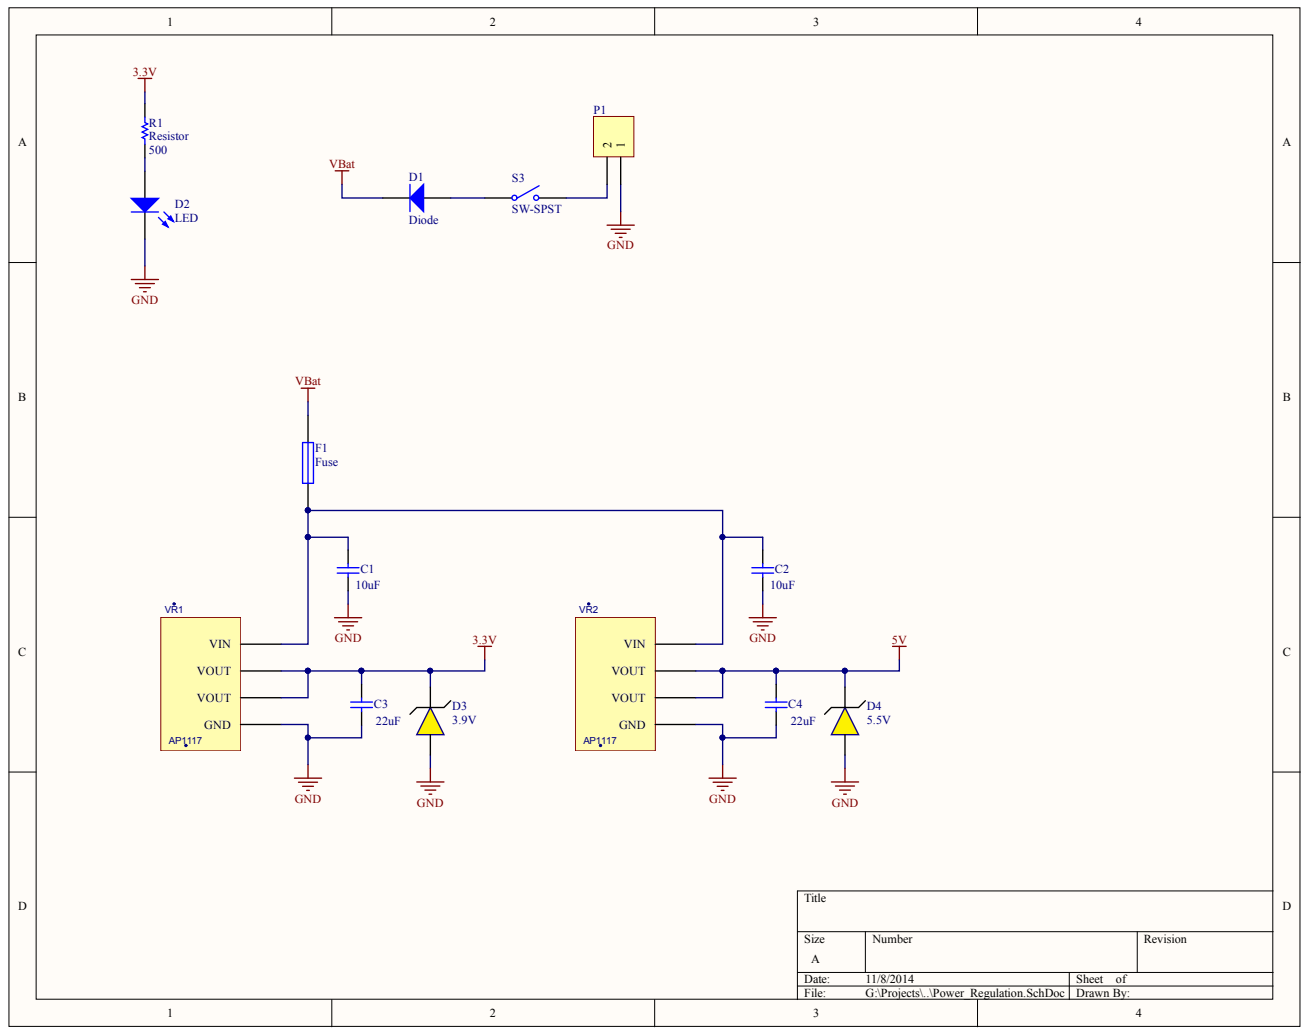
[picture p55: page 4]

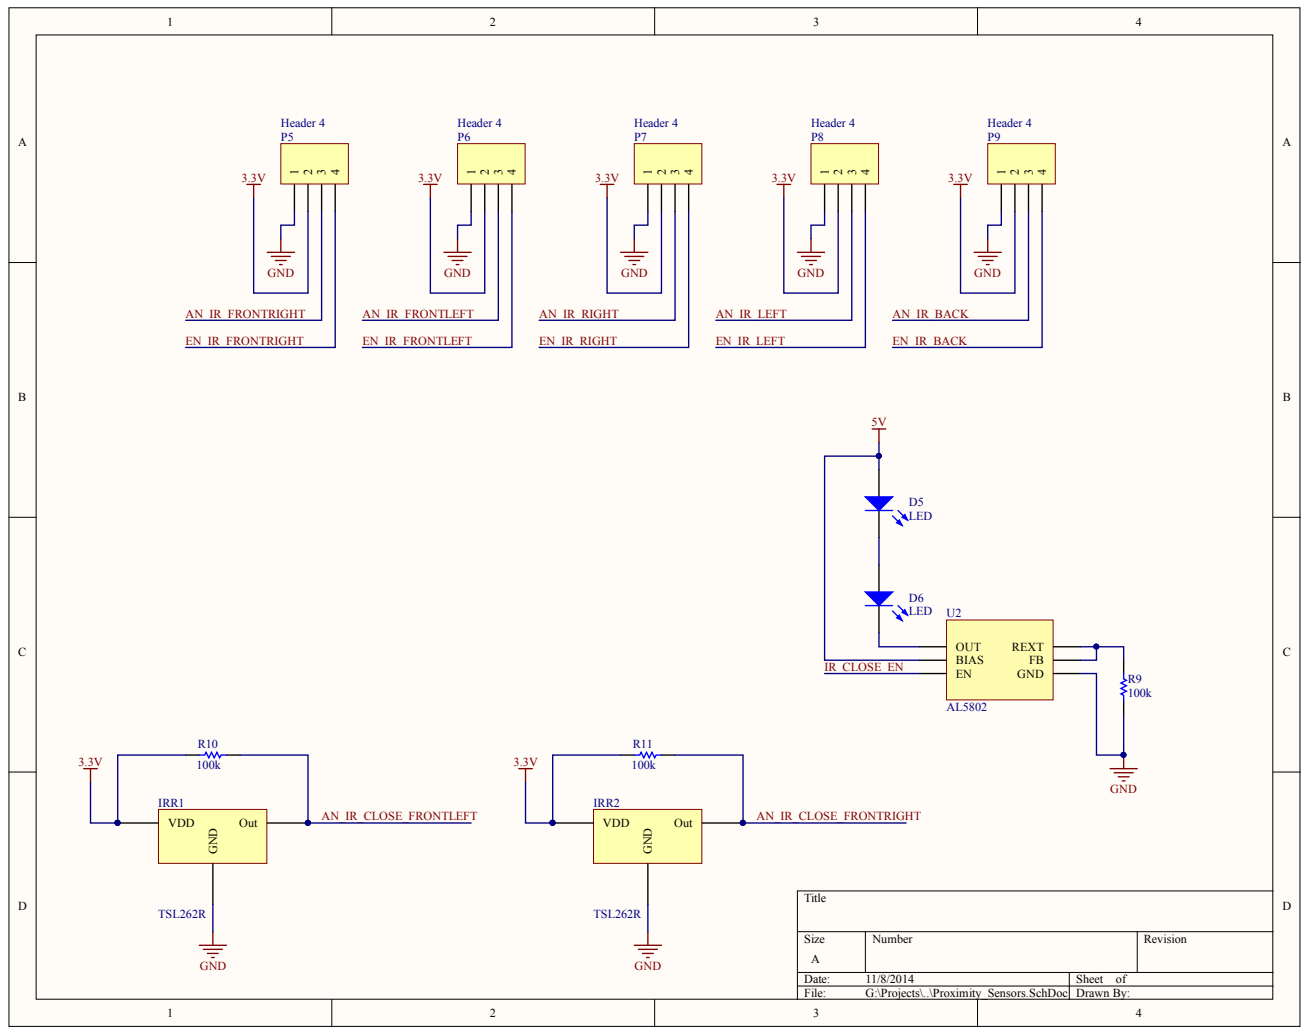
[picture p56: page 5]

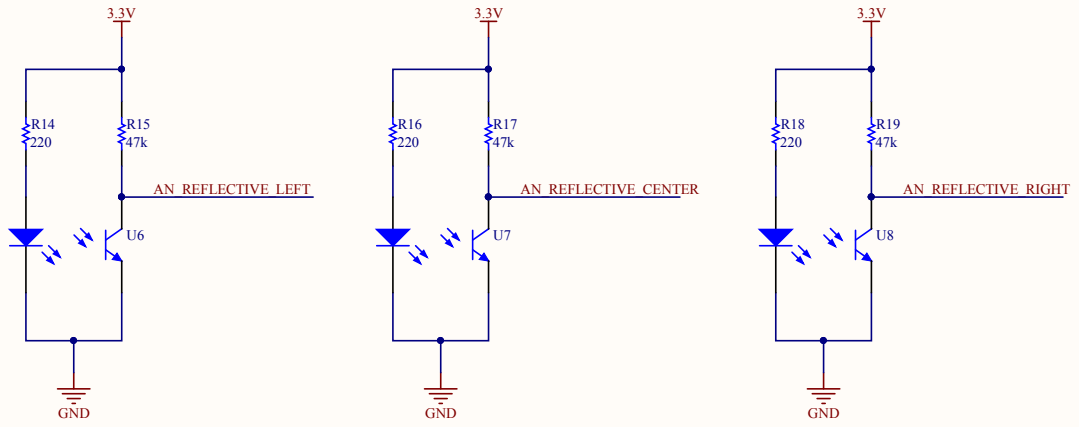
[picture p57: page 6]

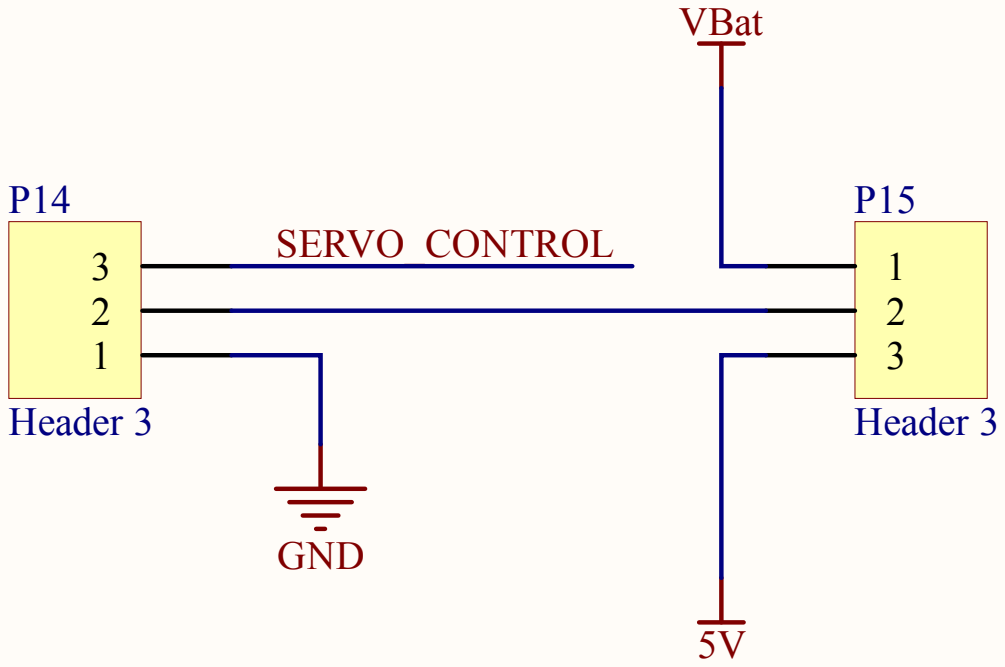
[picture p58: page 7]

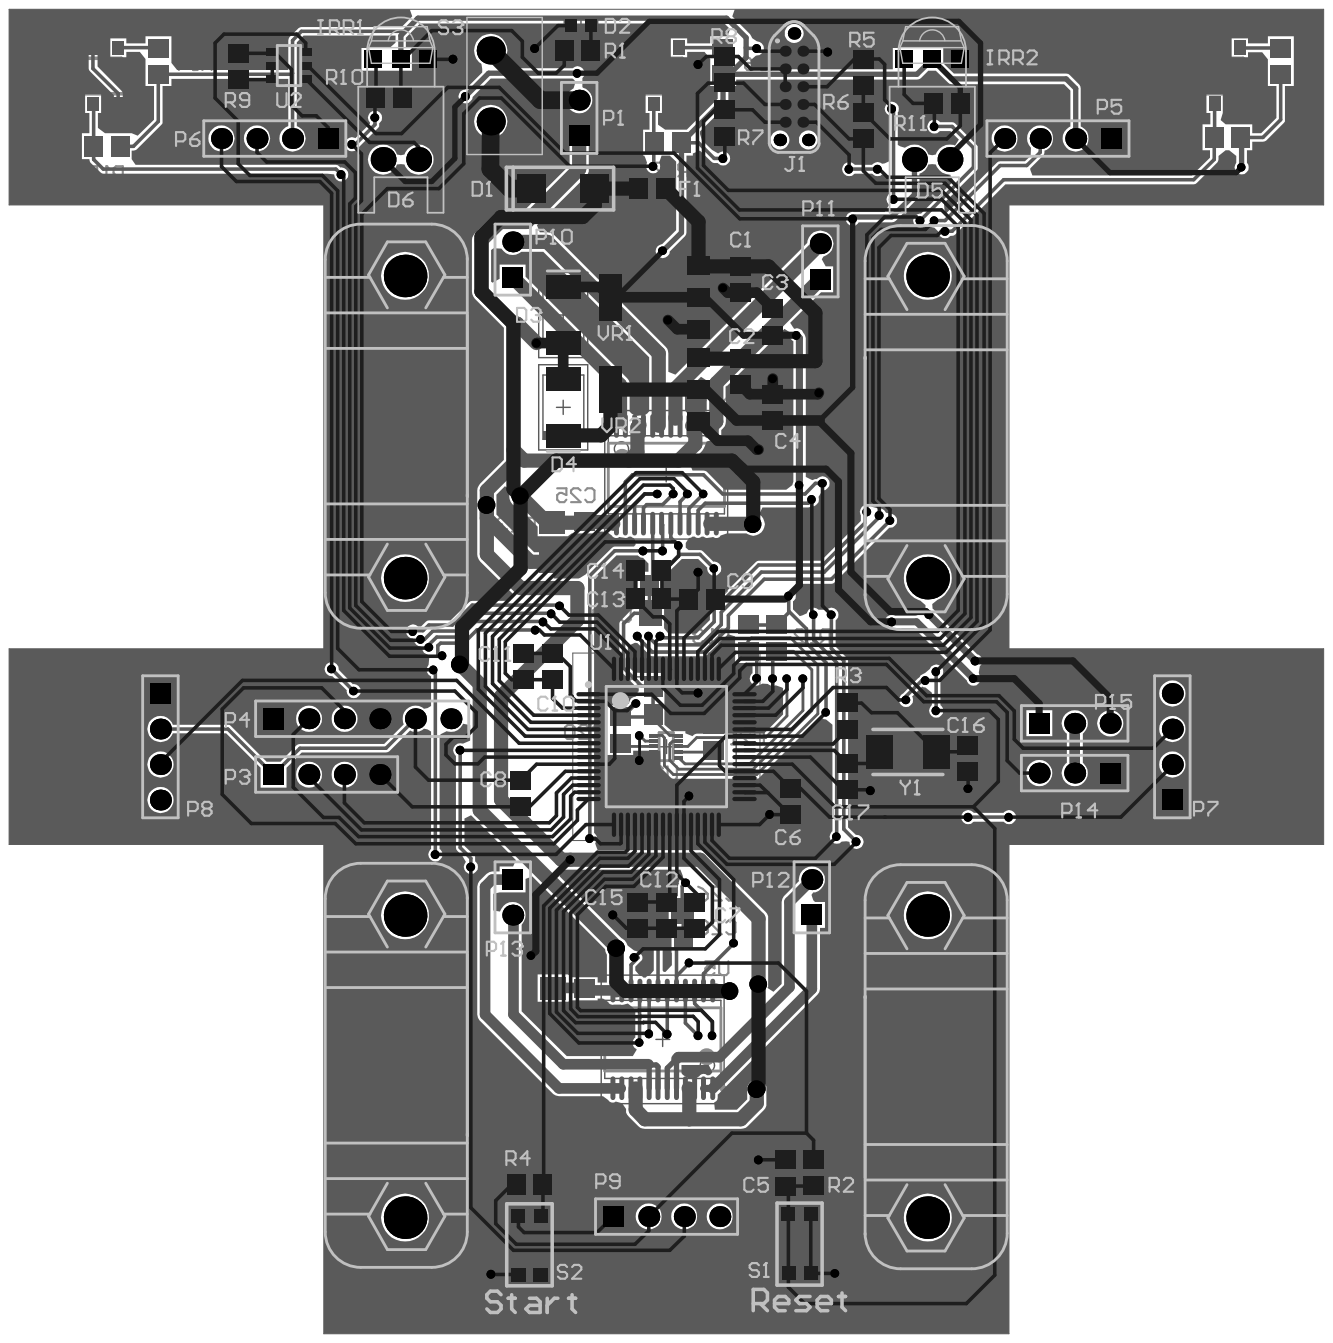
[picture p59: page 8]
