antmerlino/SumoBot/(list of files, drawings)

Other design files:
Hardware/Accelerometer.SchDoc
Hardware/microcontroller.SchDoc
Hardware/Motor_Control.SchDoc
Hardware/Power_Regulation.SchDoc
Hardware/Proximity_Sensors.SchDoc
Hardware/Reflective_Sensors.SchDoc
Hardware/Servo.SchDoc
Hardware/sumobot.PcbDoc
Hardware/SumoBot.PrjPcb
