antmerlino/SumoBot/(commit log)

2014-10-20 Initial Commit. Schematic Complete. No PCB started
    [Accelerometer.sch, Bluetooth Modem - BlueSMiRF Gold - WRL-102681.SLDPRT, BottomBoard.SLDPRT, HI-55701.SLDPRT, HS85MG - HS85MG_bottom-1.STL, HS85MG - HS85MG_midle-1.STL, HS85MG - HS85MG_top-1.STL, HS85MG - HS85MG_upper-1.STL]
2014-11-15 Adds all changes to final hardware, starts software, adds ignores to gitignore file
    [575414720.sldasm, 642238864.sldasm, 642239760.sldasm, 703633856.sldasm, 90480A003.SLDPRT, Accelerometer.SchDoc, Accelerometer.sch, BOM.ods]
2014-11-17 Makes changes to reflective driver and adds sumo header file
2014-11-18 Track enemy functionality added - needs to be tuned
2014-11-19 Added Bluetooth callback functionality. Updated Motor Frequency to fix head dissipation.
    [ir_sensors.c, main.c, motor.c, motor.h, system.h]
2014-11-21 Servo and updated files
2014-11-23 Software tweaks used during the competition 10.21.14
    [3dPrintShielding.SLDPRT, 3dPrintShielding.STL, BOM.ods, DualMotorMount.SLDASM, DualMotorMount.SLDPRT, DualMotorMount.STL, RampBracket.SLDPRT, RampBracket.STL]
